OpenPOWERFoundation/toy-sram/cell.png

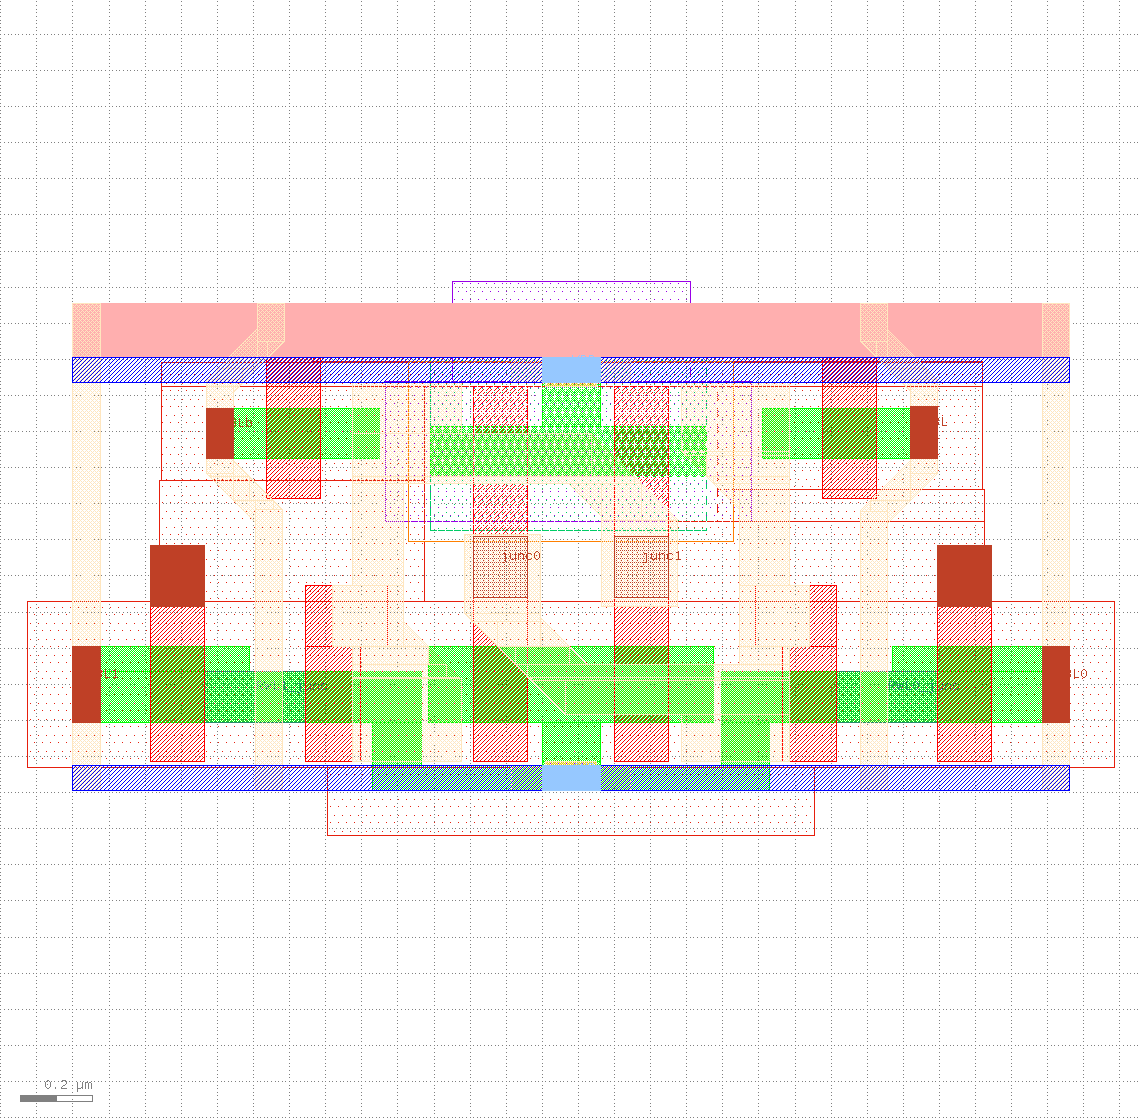
cell.png
