OpenPOWERFoundation/toy-sram/custom/10T.png

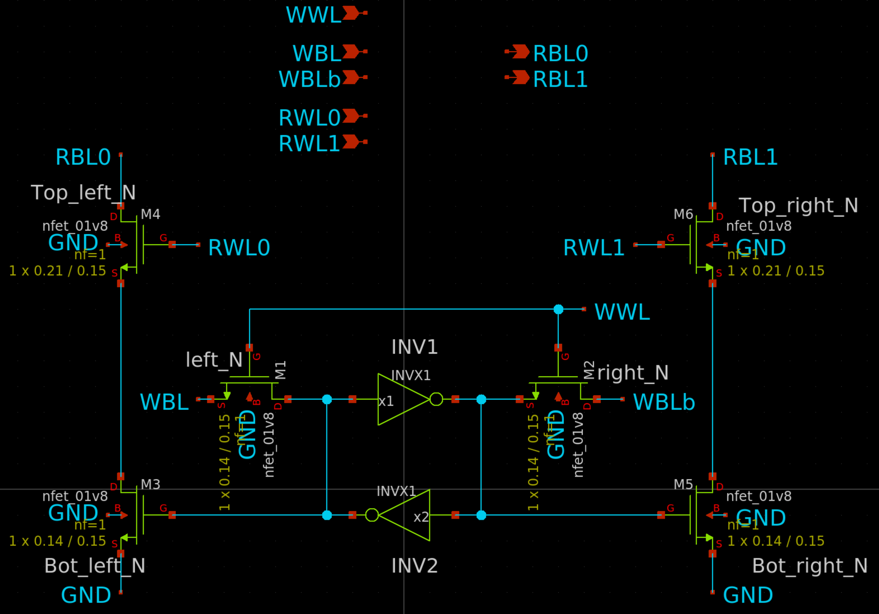
custom/10T.png
