OpenPOWERFoundation/toy-sram/custom/local_eval.png

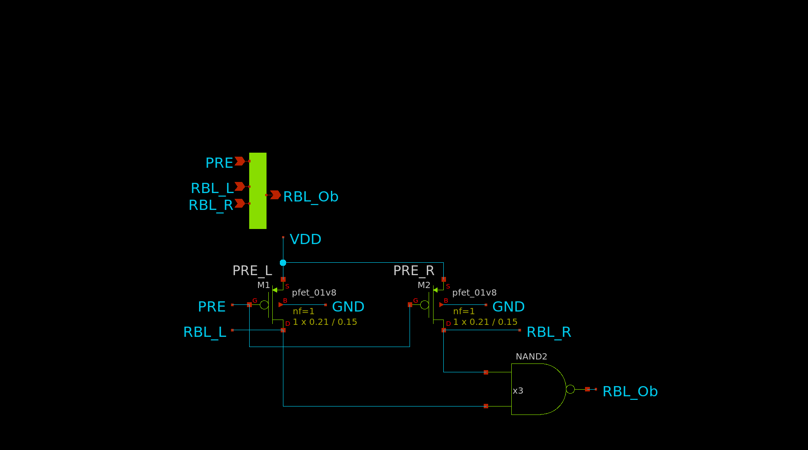
custom/local_eval.png
