OpenPOWERFoundation/toy-sram/custom/sim/Screenshot from 2022-05-25 16-05-57.png

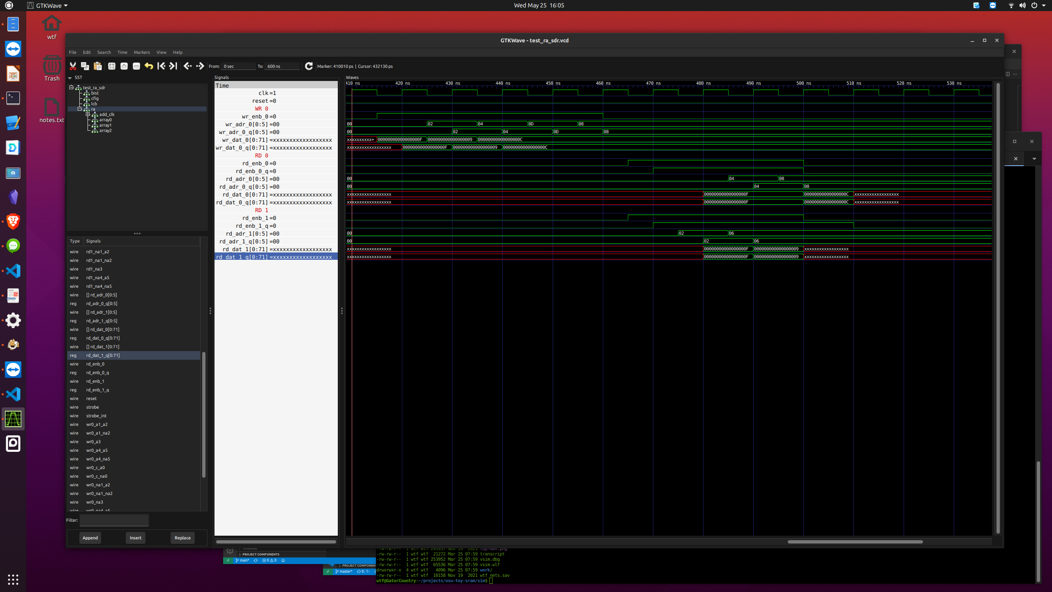
custom/sim/Screenshot from 2022-05-25 16-05-57.png
