OpenPOWERFoundation/toy-sram/custom/wtf/bit_v0.01.png

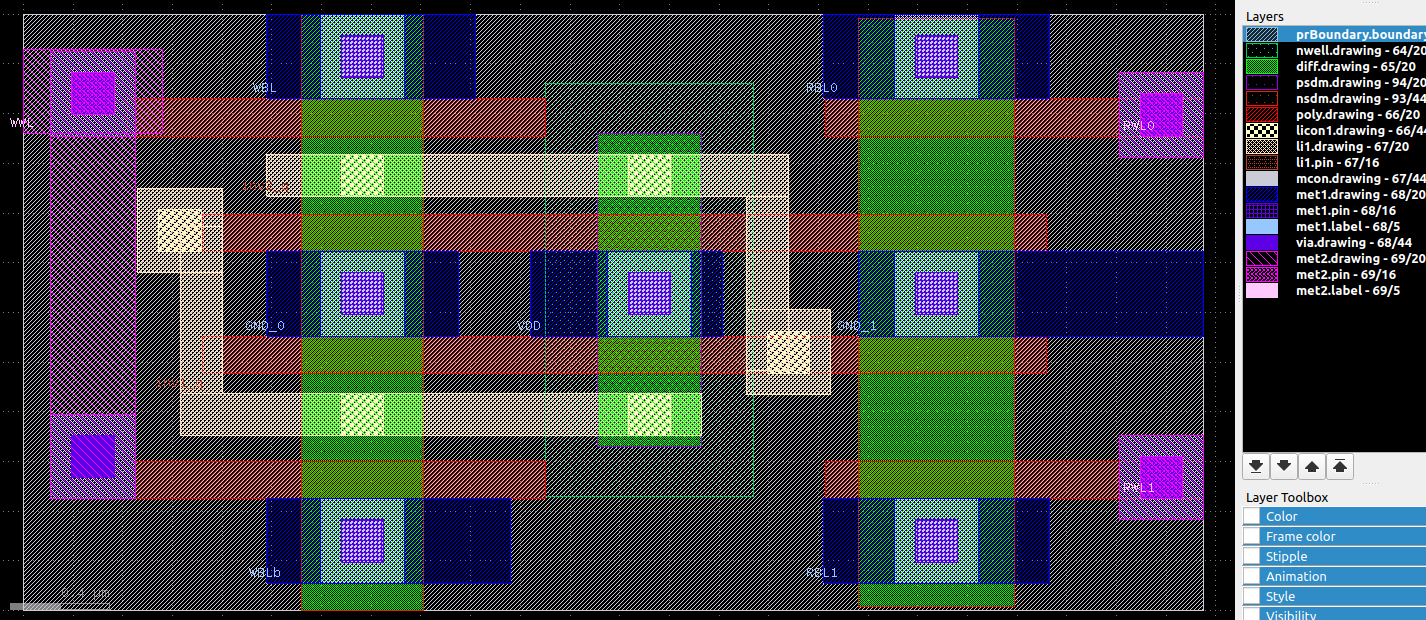
custom/wtf/bit_v0.01.png
