OpenPOWERFoundation/toy-sram/custom/wtf/irsim.png

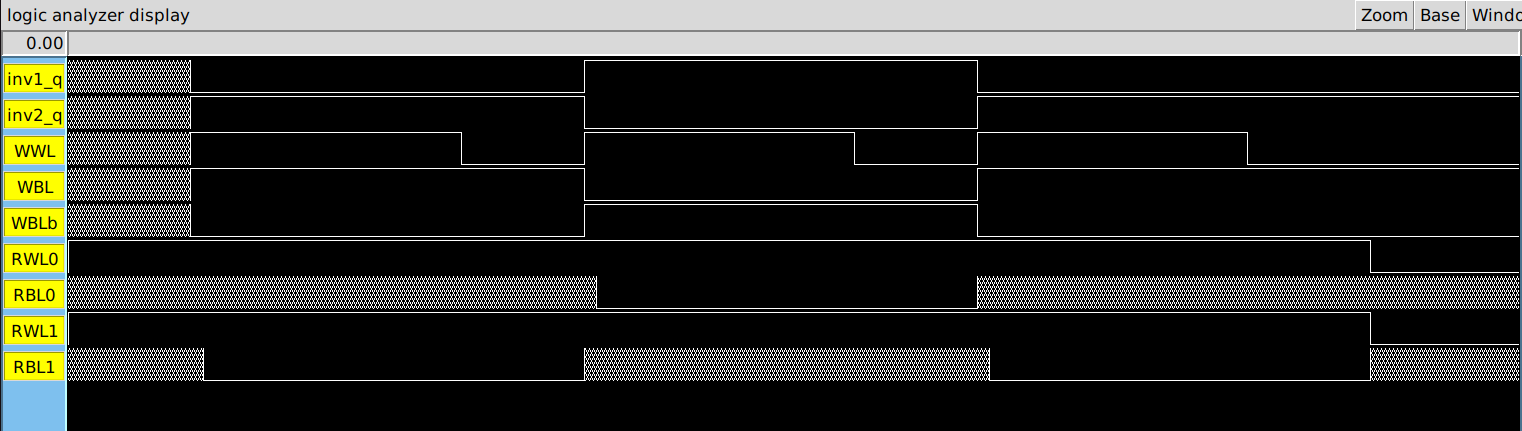
custom/wtf/irsim.png
