OpenPOWERFoundation/toy-sram/doc/slide1.png

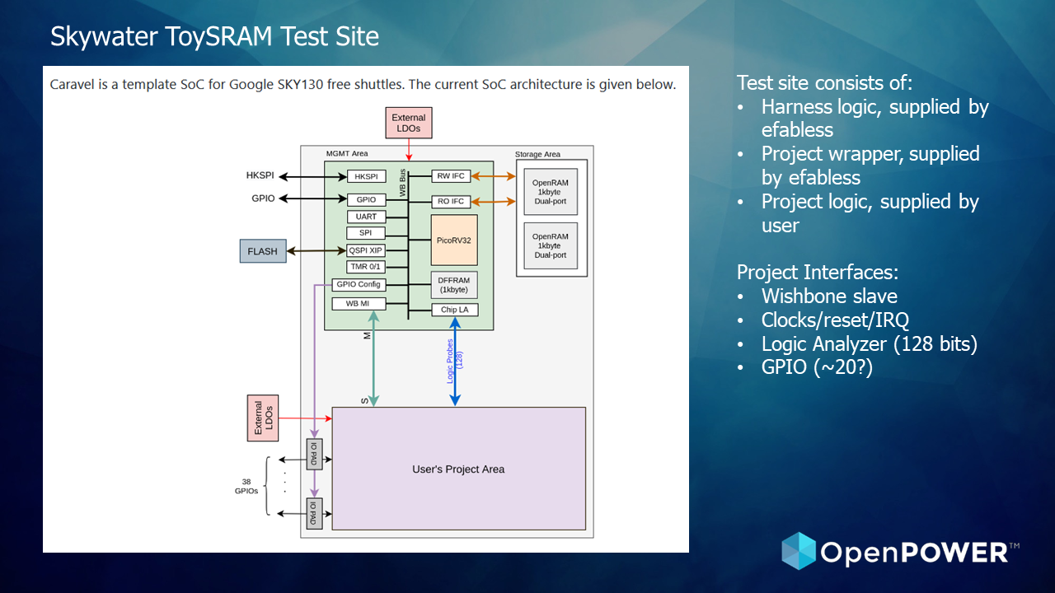
doc/slide1.png
