OpenPOWERFoundation/toy-sram/doc/slide3.png

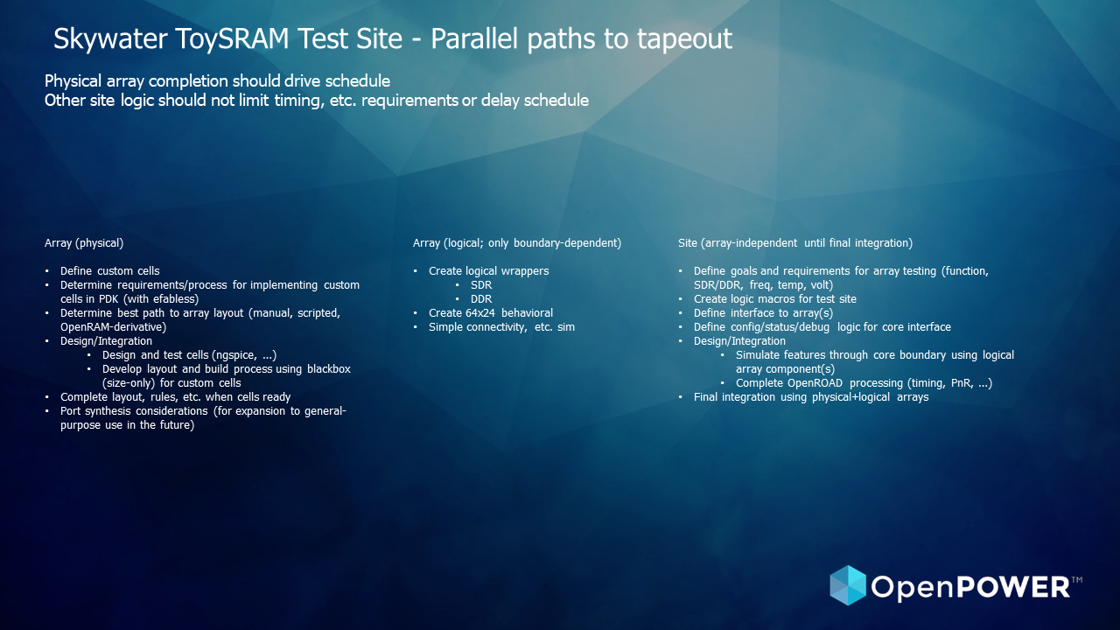
doc/slide3.png
