OpenPOWERFoundation/toy-sram/rtl/build/caravel/doc/img/bob.jpg

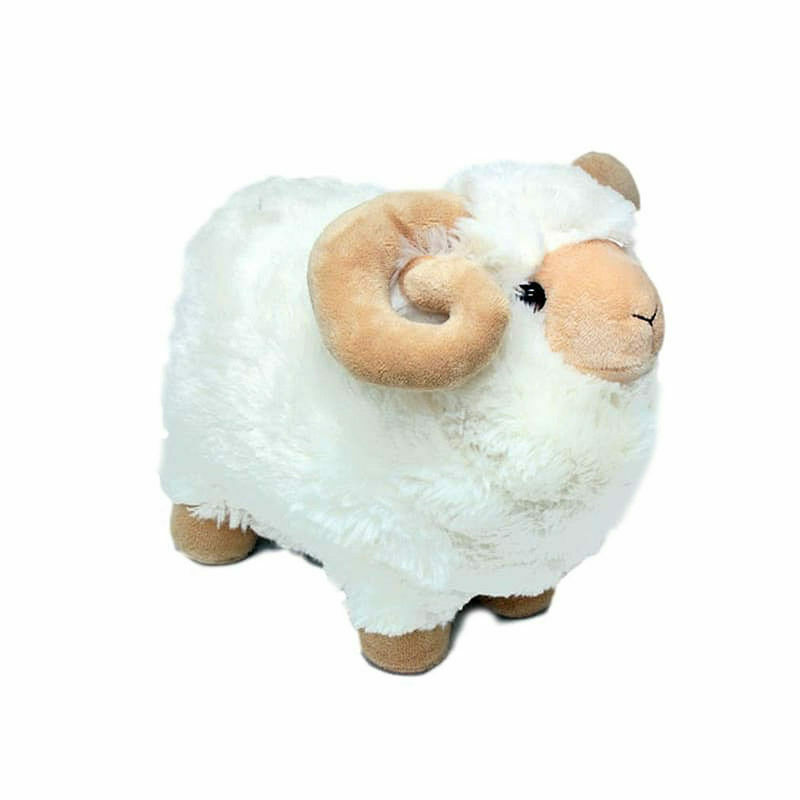
rtl/build/caravel/doc/img/bob.jpg
