OpenPOWERFoundation/toy-sram/custom/sky130A/libs.ref/sky130_fd_pr/spice/sky130_fd_pr__cap_vpp_55p8x23p1_pol1m1m2m3m4m5_noshield_test.spice

* Copyright 2020 The SkyWater PDK Authors
*
* Licensed under the Apache License, Version 2.0 (the "License");
* you may not use this file except in compliance with the License.
* You may obtain a copy of the License at
*
*     https://www.apache.org/licenses/LICENSE-2.0
*
* Unless required by applicable law or agreed to in writing, software
* distributed under the License is distributed on an "AS IS" BASIS,
* WITHOUT WARRANTIES OR CONDITIONS OF ANY KIND, either express or implied.
* See the License for the specific language governing permissions and
* limitations under the License.
*
* SPDX-License-Identifier: Apache-2.0


* Top level circuit sky130_fd_pr__cap_vpp_55p8x23p1_pol1m1m2m3m4m5_noshield_test
.end
