OpenPOWERFoundation/toy-sram/custom/lvs/10T_32x32_magic.spice

* HSPICE file created from 10T_32x32_magic.ext - technology: sky130A

.subckt x10T_toy_magic WWL RWL0 RWL1 WBL WBLb RBL0 RBL1 VDD GND
M1000 VDD junc0 junc1 VDD sky130_fd_pr__pfet_01v8 w=1 l=0.15
M1001 WBL WWL junc0 GND sky130_fd_pr__nfet_01v8 w=1 l=0.15
M1002 junc1 WWL WBLb GND sky130_fd_pr__nfet_01v8 w=1 l=0.15
M1003 GND junc0 junc1 GND sky130_fd_pr__nfet_01v8 w=1 l=0.15
M1004 RWL0_junc junc0 GND GND sky130_fd_pr__nfet_01v8 w=1 l=0.15
M1005 RBL0 RWL0 RWL0_junc GND sky130_fd_pr__nfet_01v8 w=1 l=0.15
M1006 GND junc1 RWL1_junc GND sky130_fd_pr__nfet_01v8 w=1 l=0.15
M1007 RWL1_junc RWL1 RBL1 GND sky130_fd_pr__nfet_01v8 w=1 l=0.15
M1008 junc0 junc1 GND GND sky130_fd_pr__nfet_01v8 w=1 l=0.15
M1009 junc0 junc1 VDD VDD sky130_fd_pr__pfet_01v8 w=1 l=0.15
.ends

.subckt x10T_1x8_magic RBL1_0 RBL0_0 RBL1_1 RBL0_1 RBL1_2 RBL0_2 RBL1_3 RBL1_4 RBL0_4
+ RBL1_5 RBL0_5 RBL1_6 RBL0_6 RBL1_7 RBL0_7 WWL RWL WBLb_0 WBL_0 WBLb_1 WBL_1 WBLb_2
+ WBL_2 WBLb_3 WBL_3 WBLb_4 WBL_4 WBLb_5 WBL_5 WBLb_6 WBL_6 WBLb_7 WBL_7 VDD GND x0/RBL0
+ x5/WBLb x5/RBL1 x4/WBLb x7/WBL x5/RBL0 x4/RBL1 x1/WBLb x4/RBL0 x6/WBL x1/RBL1 x1/RBL0
+ x7/WBLb x3/WBL x5/WWL x7/RBL1 x6/WBLb x7/RBL0 x2/WBL x6/RBL1 x6/RBL0 x0/WBL x5/VDD
+ x3/WBLb x5/WBL x3/RBL1 x2/WBLb x4/WBL x3/RBL0 x2/RBL1 x0/WBLb x2/RBL0 x1/WBL x0/RBL1
+ VSUBS
X10T_toy_magic_0 x5/WWL RWL RWL x0/WBL x0/WBLb x0/RBL0 x0/RBL1 x5/VDD VSUBS x10T_toy_magic
X10T_toy_magic_1 x5/WWL RWL RWL x1/WBL x1/WBLb x1/RBL0 x1/RBL1 x5/VDD VSUBS x10T_toy_magic
X10T_toy_magic_3 x5/WWL RWL RWL x2/WBL x2/WBLb x2/RBL0 x2/RBL1 x5/VDD VSUBS x10T_toy_magic
X10T_toy_magic_2 x5/WWL RWL RWL x6/WBL x6/WBLb x6/RBL0 x6/RBL1 x5/VDD VSUBS x10T_toy_magic
X10T_toy_magic_4 x5/WWL RWL RWL x4/WBL x4/WBLb x4/RBL0 x4/RBL1 x5/VDD VSUBS x10T_toy_magic
X10T_toy_magic_5 x5/WWL RWL RWL x7/WBL x7/WBLb x7/RBL0 x7/RBL1 x5/VDD VSUBS x10T_toy_magic
X10T_toy_magic_6 x5/WWL RWL RWL x3/WBL x3/WBLb x3/RBL0 x3/RBL1 x5/VDD VSUBS x10T_toy_magic
X10T_toy_magic_7 x5/WWL RWL RWL x5/WBL x5/WBLb x5/RBL0 x5/RBL1 x5/VDD VSUBS x10T_toy_magic
.ends

.subckt x10T_32x32_magic RBL1_0 RBL0_0 RBL1_1 RBL0_1 RBL1_2 RBL0_2 RBL1_3 RBL0_3 RBL1_4
+ RBL0_4 RBL1_5 RBL0_5 RBL1_6 RBL0_6 RBL1_7 RBL0_7 RBL1_8 RBL0_8 RBL1_9 RBL0_9 RBL1_10
+ RBL0_10 RBL1_11 RBL0_11 RBL1_12 RBL0_12 RBL1_13 RBL0_13 RBL1_14 RBL0_14 RBL1_15
+ RBL0_15 WWL_0 RWL_0 WWL_1 RWL_1 WWL_2 RWL_2 WWL_3 RWL_3 WWL_4 RWL_4 WWL_5 RWL_5
+ WWL_6 RWL_6 WWL_7 RWL_7 WWL_8 RWL_8 WWL_9 RWL_9 WWL_10 RWL_10 WWL_11 RWL_11 WWL_12
+ RWL_12 WWL_13 RWL_13 WWL_14 RWL_14 WWL_15 RWL_15 WWL_16 RWL_16 WWL_17 RWL_17 WWL_18
+ RWL_18 WWL_19 RWL_19 WWL_20 RWL_20 WWL_21 RWL_21 WWL_22 RWL_22 WWL_23 RWL_23 WWL_24
+ RWL_24 WWL_25 RWL_25 WWL_26 RWL_26 WWL_27 RWL_27 WWL_28 RWL_28 WWL_29 RWL_29 WWL_30
+ RWL_30 WWL_31 RWL_31 RBL1_16 RBL0_16 RBL1_17 RBL0_17 RBL1_18 RBL0_18 RBL1_19 RBL0_19
+ RBL1_20 RBL0_20 RBL1_21 RBL0_21 RBL1_22 RBL0_22 RBL1_23 RBL0_23 RBL1_24 RBL0_24
+ RBL1_25 RBL0_25 RBL1_26 RBL0_26 RBL1_27 RBL0_27 RBL1_28 RBL0_28 RBL1_29 RBL0_29
+ RBL1_30 RBL0_30 RBL1_31 RBL0_31 WBL_0 WBLb_0 WBL_1 WBLb_1 WBL_2 WBLb_2 WBL_3 WBLb_19
+ WBL_4 WBLb_4 WBL_5 WBLb_5 WBL_22 WBLb_6 WBL_23 WBLb_7 WBL_24 WBLb_8 WBL_25 WBLb_9
+ WBL_26 WBLb_10 WBL_11 WBLb_11 WBL_12 WBLb_12 WBL_13 WBLb_13 WBL_14 WBLb_30 WBL_15
+ WBLb_31 VDD GND
X10T_1x8_magic_0 RBL1_0 RBL0_0 RBL1_1 RBL0_1 RBL1_2 RBL0_2 RBL1_3 RBL1_4 RBL0_4 RBL1_5
+ RBL0_5 RBL1_6 RBL0_6 RBL1_7 RBL0_7 WWL_2 RWL_2 WBLb_0 WBL_0 WBLb_1 WBL_1 WBLb_2
+ WBL_2 WBLb_3 WBL_3 WBLb_4 WBL_4 WBLb_5 WBL_5 WBLb_6 WBL_6 WBLb_7 WBL_7 VDD GND RBL0_6
+ x0/WBLb RBL1_0 x1/WBLb x2/WBL RBL0_0 RBL1_3 x3/WBLb RBL0_3 x4/WBL RBL1_7 RBL0_7
+ x2/WBLb x5/WBL x6/WWL RBL1_2 x4/WBLb RBL0_2 x7/WBL RBL1_5 RBL0_5 x8/WBL x6/VDD x5/WBLb
+ x0/WBL RBL1_1 x7/WBLb x1/WBL RBL0_1 RBL1_4 x8/WBLb RBL0_4 x3/WBL RBL1_6 VSUBS x10T_1x8_magic
X10T_1x8_magic_1 RBL1_0 RBL0_0 RBL1_1 RBL0_1 RBL1_2 RBL0_2 RBL1_3 RBL1_4 RBL0_4 RBL1_5
+ RBL0_5 RBL1_6 RBL0_6 RBL1_7 RBL0_7 WWL_3 RWL_3 WBLb_0 WBL_0 WBLb_1 WBL_1 WBLb_2
+ WBL_2 WBLb_3 WBL_3 WBLb_4 WBL_4 WBLb_5 WBL_5 WBLb_6 WBL_6 WBLb_7 WBL_7 VDD GND x9/RBL0
+ x10/WBLb x10/RBL1 x11/WBLb x12/WBL x10/RBL0 x11/RBL1 x13/WBLb x11/RBL0 x14/WBL x13/RBL1
+ x13/RBL0 x12/WBLb x15/WBL x16/WWL x12/RBL1 x14/WBLb x12/RBL0 x17/WBL x14/RBL1 x14/RBL0
+ x9/WBL x16/VDD x15/WBLb x10/WBL x15/RBL1 x17/WBLb x11/WBL x15/RBL0 x17/RBL1 x9/WBLb
+ x17/RBL0 x13/WBL x9/RBL1 VSUBS x10T_1x8_magic
X10T_1x8_magic_2 RBL1_0 RBL0_0 RBL1_1 RBL0_1 RBL1_2 RBL0_2 RBL1_3 RBL1_4 RBL0_4 RBL1_5
+ RBL0_5 RBL1_6 RBL0_6 RBL1_7 RBL0_7 WWL_0 RWL_0 WBLb_0 WBL_0 WBLb_1 WBL_1 WBLb_2
+ WBL_2 WBLb_3 WBL_3 WBLb_4 WBL_4 WBLb_5 WBL_5 WBLb_6 WBL_6 WBLb_7 WBL_7 VDD GND x18/RBL0
+ x19/WBLb x19/RBL1 x20/WBLb x21/WBL x19/RBL0 x20/RBL1 x22/WBLb x20/RBL0 x23/WBL x22/RBL1
+ x22/RBL0 x21/WBLb x24/WBL x25/WWL x21/RBL1 x23/WBLb x21/RBL0 x26/WBL x23/RBL1 x23/RBL0
+ x18/WBL x25/VDD x24/WBLb x19/WBL x24/RBL1 x26/WBLb x20/WBL x24/RBL0 x26/RBL1 x18/WBLb
+ x26/RBL0 x22/WBL x18/RBL1 VSUBS x10T_1x8_magic
X10T_1x8_magic_3 RBL1_0 RBL0_0 RBL1_1 RBL0_1 RBL1_2 RBL0_2 RBL1_3 RBL1_4 RBL0_4 RBL1_5
+ RBL0_5 RBL1_6 RBL0_6 RBL1_7 RBL0_7 WWL_1 RWL_1 WBLb_0 WBL_0 WBLb_1 WBL_1 WBLb_2
+ WBL_2 WBLb_3 WBL_3 WBLb_4 WBL_4 WBLb_5 WBL_5 WBLb_6 WBL_6 WBLb_7 WBL_7 VDD GND x27/RBL0
+ x28/WBLb x28/RBL1 x29/WBLb x30/WBL x28/RBL0 x29/RBL1 x31/WBLb x29/RBL0 x32/WBL x31/RBL1
+ x31/RBL0 x30/WBLb x33/WBL x34/WWL x30/RBL1 x32/WBLb x30/RBL0 x35/WBL x32/RBL1 x32/RBL0
+ x27/WBL x34/VDD x33/WBLb x28/WBL x33/RBL1 x35/WBLb x29/WBL x33/RBL0 x35/RBL1 x27/WBLb
+ x35/RBL0 x31/WBL x27/RBL1 VSUBS x10T_1x8_magic
X10T_1x8_magic_4 RBL1_0 RBL0_0 RBL1_1 RBL0_1 RBL1_2 RBL0_2 RBL1_3 RBL1_4 RBL0_4 RBL1_5
+ RBL0_5 RBL1_6 RBL0_6 RBL1_7 RBL0_7 WWL_7 RWL_7 WBLb_0 WBL_0 WBLb_1 WBL_1 WBLb_2
+ WBL_2 WBLb_3 WBL_3 WBLb_4 WBL_4 WBLb_5 WBL_5 WBLb_6 WBL_6 WBLb_7 WBL_7 VDD GND RBL0_6
+ x36/WBLb RBL1_0 x37/WBLb x38/WBL RBL0_0 RBL1_3 x39/WBLb RBL0_3 x40/WBL RBL1_7 RBL0_7
+ x38/WBLb x41/WBL x42/WWL RBL1_2 x40/WBLb RBL0_2 x43/WBL RBL1_5 RBL0_5 x44/WBL x42/VDD
+ x41/WBLb x36/WBL RBL1_1 x43/WBLb x37/WBL RBL0_1 RBL1_4 x44/WBLb RBL0_4 x39/WBL RBL1_6
+ VSUBS x10T_1x8_magic
X10T_1x8_magic_5 RBL1_0 RBL0_0 RBL1_1 RBL0_1 RBL1_2 RBL0_2 RBL1_3 RBL1_4 RBL0_4 RBL1_5
+ RBL0_5 RBL1_6 RBL0_6 RBL1_7 RBL0_7 WWL_6 RWL_6 WBLb_0 WBL_0 WBLb_1 WBL_1 WBLb_2
+ WBL_2 WBLb_3 WBL_3 WBLb_4 WBL_4 WBLb_5 WBL_5 WBLb_6 WBL_6 WBLb_7 WBL_7 VDD GND x45/RBL0
+ x46/WBLb x46/RBL1 x47/WBLb x48/WBL x46/RBL0 x47/RBL1 x49/WBLb x47/RBL0 x50/WBL x49/RBL1
+ x49/RBL0 x48/WBLb x51/WBL x52/WWL x48/RBL1 x50/WBLb x48/RBL0 x53/WBL x50/RBL1 x50/RBL0
+ x45/WBL x52/VDD x51/WBLb x46/WBL x51/RBL1 x53/WBLb x47/WBL x51/RBL0 x53/RBL1 x45/WBLb
+ x53/RBL0 x49/WBL x45/RBL1 VSUBS x10T_1x8_magic
X10T_1x8_magic_6 RBL1_0 RBL0_0 RBL1_1 RBL0_1 RBL1_2 RBL0_2 RBL1_3 RBL1_4 RBL0_4 RBL1_5
+ RBL0_5 RBL1_6 RBL0_6 RBL1_7 RBL0_7 WWL_4 RWL_4 WBLb_0 WBL_0 WBLb_1 WBL_1 WBLb_2
+ WBL_2 WBLb_3 WBL_3 WBLb_4 WBL_4 WBLb_5 WBL_5 WBLb_6 WBL_6 WBLb_7 WBL_7 VDD GND x54/RBL0
+ WBLb_0 x55/RBL1 WBLb_3 WBL_2 x55/RBL0 x56/RBL1 WBLb_7 x56/RBL0 WBL_5 x57/RBL1 x57/RBL0
+ WBLb_2 WBL_1 x58/WWL x59/RBL1 WBLb_5 x59/RBL0 WBL_4 x60/RBL1 x60/RBL0 WBL_6 x58/VDD
+ WBLb_1 WBL_0 x61/RBL1 WBLb_4 WBL_3 x61/RBL0 x62/RBL1 WBLb_6 x62/RBL0 WBL_7 x54/RBL1
+ VSUBS x10T_1x8_magic
X10T_1x8_magic_7 RBL1_0 RBL0_0 RBL1_1 RBL0_1 RBL1_2 RBL0_2 RBL1_3 RBL1_4 RBL0_4 RBL1_5
+ RBL0_5 RBL1_6 RBL0_6 RBL1_7 RBL0_7 WWL_5 RWL_5 WBLb_0 WBL_0 WBLb_1 WBL_1 WBLb_2
+ WBL_2 WBLb_3 WBL_3 WBLb_4 WBL_4 WBLb_5 WBL_5 WBLb_6 WBL_6 WBLb_7 WBL_7 VDD GND x63/RBL0
+ x64/WBLb x64/RBL1 x65/WBLb x66/WBL x64/RBL0 x65/RBL1 x67/WBLb x65/RBL0 x68/WBL x67/RBL1
+ x67/RBL0 x66/WBLb x69/WBL x70/WWL x66/RBL1 x68/WBLb x66/RBL0 x71/WBL x68/RBL1 x68/RBL0
+ x63/WBL x70/VDD x69/WBLb x64/WBL x69/RBL1 x71/WBLb x65/WBL x69/RBL0 x71/RBL1 x63/WBLb
+ x71/RBL0 x67/WBL x63/RBL1 VSUBS x10T_1x8_magic
X10T_1x8_magic_90 RBL1_16 RBL0_16 RBL1_17 RBL0_17 RBL1_18 RBL0_18 RBL1_19 RBL1_20
+ RBL0_20 RBL1_21 RBL0_21 RBL1_22 RBL0_22 RBL1_23 RBL0_23 x72/WWL RWL_17 WBLb_16 WBL_16
+ WBLb_17 WBL_17 WBLb_18 WBL_18 WBLb_19 WBL_19 WBLb_20 WBL_20 WBLb_21 WBL_21 WBLb_22
+ WBL_22 WBLb_23 WBL_23 x72/VDD VSUBS x73/RBL0 WBLb_16 x74/RBL1 x75/WBLb x76/WBL x74/RBL0
+ x75/RBL1 x77/WBLb x75/RBL0 x78/WBL x77/RBL1 x77/RBL0 x76/WBLb x79/WBL x80/WWL x76/RBL1
+ x78/WBLb x76/RBL0 x81/WBL RBL1_21 x78/RBL0 x73/WBL x80/VDD x79/WBLb x74/WBL x79/RBL1
+ x81/WBLb x75/WBL x79/RBL0 x81/RBL1 x73/WBLb x81/RBL0 x77/WBL x73/RBL1 VSUBS x10T_1x8_magic
X10T_1x8_magic_8 RBL1_0 RBL0_0 RBL1_1 RBL0_1 RBL1_2 RBL0_2 RBL1_3 RBL1_4 RBL0_4 RBL1_5
+ RBL0_5 RBL1_6 RBL0_6 RBL1_7 RBL0_7 WWL_14 RWL_14 WBLb_0 WBL_0 WBLb_1 WBL_1 WBLb_2
+ WBL_2 WBLb_3 WBL_3 WBLb_4 WBL_4 WBLb_5 WBL_5 WBLb_6 WBL_6 WBLb_7 WBL_7 VDD GND RBL0_6
+ WBLb_0 RBL1_0 WBLb_3 WBL_2 RBL0_0 RBL1_3 WBLb_7 RBL0_3 WBL_5 RBL1_7 RBL0_7 WBLb_2
+ WBL_1 x82/WWL RBL1_2 WBLb_5 RBL0_2 WBL_4 RBL1_5 RBL0_5 WBL_6 x82/VDD WBLb_1 WBL_0
+ RBL1_1 WBLb_4 WBL_3 RBL0_1 RBL1_4 WBLb_6 RBL0_4 WBL_7 RBL1_6 VSUBS x10T_1x8_magic
X10T_1x8_magic_80 RBL1_16 RBL0_16 RBL1_17 RBL0_17 RBL1_18 RBL0_18 RBL1_19 RBL1_20
+ RBL0_20 RBL1_21 RBL0_21 RBL1_22 RBL0_22 RBL1_23 RBL0_23 x83/WWL RWL_23 WBLb_16 WBL_16
+ WBLb_17 WBL_17 WBLb_18 WBL_18 WBLb_19 WBL_19 WBLb_20 WBL_20 WBLb_21 WBL_21 WBLb_22
+ WBL_22 WBLb_23 WBL_23 VDD VSUBS RBL0_22 WBLb_16 RBL1_16 WBLb_19 WBL_18 RBL0_16 RBL1_19
+ WBLb_23 RBL0_19 WBL_21 RBL1_23 RBL0_23 WBLb_18 WBL_17 x84/WWL RBL1_18 WBLb_21 RBL0_18
+ WBL_20 RBL1_21 RBL0_21 WBL_22 VDD WBLb_17 WBL_16 RBL1_17 WBLb_20 WBL_19 RBL0_17
+ RBL1_20 WBLb_22 RBL0_20 WBL_23 RBL1_22 VSUBS x10T_1x8_magic
X10T_1x8_magic_91 RBL1_16 RBL0_16 RBL1_17 RBL0_17 RBL1_18 RBL0_18 RBL1_19 RBL1_20
+ RBL0_20 RBL1_21 RBL0_21 RBL1_22 RBL0_22 RBL1_23 RBL0_23 x85/WWL RWL_18 WBLb_16 WBL_16
+ WBLb_17 WBL_17 WBLb_18 WBL_18 WBLb_19 WBL_19 WBLb_20 WBL_20 WBLb_21 WBL_21 WBLb_22
+ WBL_22 WBLb_23 WBL_23 x85/VDD VSUBS x86/RBL0 WBLb_16 x87/RBL1 x88/WBLb x89/WBL x87/RBL0
+ x88/RBL1 x90/WBLb x88/RBL0 x91/WBL x90/RBL1 x90/RBL0 x89/WBLb x92/WBL x93/WWL x89/RBL1
+ x91/WBLb x89/RBL0 x94/WBL RBL1_21 x91/RBL0 x86/WBL x93/VDD x92/WBLb x87/WBL x92/RBL1
+ x94/WBLb x88/WBL x92/RBL0 x94/RBL1 x86/WBLb x94/RBL0 x90/WBL x86/RBL1 VSUBS x10T_1x8_magic
X10T_1x8_magic_70 RBL1_16 RBL0_16 RBL1_17 RBL0_17 RBL1_18 RBL0_18 RBL1_19 RBL1_20
+ RBL0_20 RBL1_21 RBL0_21 RBL1_22 RBL0_22 RBL1_23 RBL0_23 x95/WWL RWL_28 WBLb_16 WBL_16
+ WBLb_17 WBL_17 WBLb_18 WBL_18 WBLb_19 WBL_19 WBLb_20 WBL_20 WBLb_21 WBL_21 WBLb_22
+ WBL_22 WBLb_23 WBL_23 x95/VDD VSUBS RBL0_22 WBLb_16 RBL1_16 x96/WBLb x97/WBL RBL0_16
+ RBL1_19 x98/WBLb RBL0_19 x99/WBL RBL1_23 RBL0_23 x97/WBLb x100/WBL x101/WWL RBL1_18
+ x99/WBLb RBL0_18 x102/WBL RBL1_21 RBL0_21 x103/WBL x101/VDD x100/WBLb x104/WBL RBL1_17
+ x102/WBLb x96/WBL RBL0_17 RBL1_20 x103/WBLb RBL0_20 x98/WBL RBL1_22 VSUBS x10T_1x8_magic
X10T_1x8_magic_81 RBL1_24 RBL0_24 RBL1_25 RBL0_25 RBL1_26 RBL0_26 RBL1_27 RBL1_28
+ RBL0_28 RBL1_29 RBL0_29 RBL1_30 RBL0_30 RBL1_31 RBL0_31 x84/WWL RWL_23 WBLb_24 WBL_24
+ WBLb_25 WBL_25 WBLb_26 WBL_26 WBLb_27 WBL_27 WBLb_28 WBL_28 WBLb_29 WBL_29 WBLb_30
+ WBL_30 WBLb_31 WBL_31 VDD VSUBS RBL0_30 WBLb_24 RBL1_24 WBLb_27 WBL_26 RBL0_24 RBL1_27
+ WBLb_31 RBL0_27 WBL_29 RBL1_31 RBL0_31 WBLb_26 WBL_25 x105/WWL RBL1_26 WBLb_29 RBL0_26
+ WBL_28 RBL1_29 RBL0_29 WBL_30 VDD WBLb_25 WBL_24 RBL1_25 WBLb_28 WBL_27 RBL0_25
+ RBL1_28 WBLb_30 RBL0_28 WBL_31 RBL1_30 VSUBS x10T_1x8_magic
X10T_1x8_magic_92 RBL1_24 RBL0_24 RBL1_25 RBL0_25 RBL1_26 RBL0_26 RBL1_27 RBL1_28
+ RBL0_28 RBL1_29 RBL0_29 RBL1_30 RBL0_30 RBL1_31 RBL0_31 x80/WWL RWL_17 WBLb_24 WBL_24
+ WBLb_25 WBL_25 WBLb_26 WBL_26 WBLb_27 WBL_27 WBLb_28 WBL_28 WBLb_29 WBL_29 WBLb_30
+ WBL_30 WBLb_31 WBL_31 x80/VDD VSUBS x106/RBL0 x107/WBLb x107/RBL1 x108/WBLb x109/WBL
+ x107/RBL0 x108/RBL1 x110/WBLb x108/RBL0 x111/WBL x110/RBL1 x110/RBL0 x109/WBLb x112/WBL
+ x107/WWL x109/RBL1 x111/WBLb x109/RBL0 x113/WBL x111/RBL1 x111/RBL0 x106/WBL x107/VDD
+ x112/WBLb x107/WBL x112/RBL1 x113/WBLb x108/WBL x112/RBL0 x113/RBL1 x106/WBLb x113/RBL0
+ x110/WBL x106/RBL1 VSUBS x10T_1x8_magic
X10T_1x8_magic_9 RBL1_0 RBL0_0 RBL1_1 RBL0_1 RBL1_2 RBL0_2 RBL1_3 RBL1_4 RBL0_4 RBL1_5
+ RBL0_5 RBL1_6 RBL0_6 RBL1_7 RBL0_7 WWL_15 RWL_15 WBLb_0 WBL_0 WBLb_1 WBL_1 WBLb_2
+ WBL_2 WBLb_3 WBL_3 WBLb_4 WBL_4 WBLb_5 WBL_5 WBLb_6 WBL_6 WBLb_7 WBL_7 VDD GND x114/RBL0
+ x115/WBLb x115/RBL1 x116/WBLb x117/WBL x115/RBL0 x116/RBL1 x118/WBLb x116/RBL0 x119/WBL
+ x118/RBL1 x118/RBL0 x117/WBLb x120/WBL x121/WWL x117/RBL1 x119/WBLb x117/RBL0 x122/WBL
+ x119/RBL1 x119/RBL0 x114/WBL x121/VDD x120/WBLb x115/WBL x120/RBL1 x122/WBLb x116/WBL
+ x120/RBL0 x122/RBL1 x114/WBLb x122/RBL0 x118/WBL x114/RBL1 VSUBS x10T_1x8_magic
X10T_1x8_magic_60 RBL1_8 RBL0_8 RBL1_9 RBL0_9 RBL1_10 RBL0_10 RBL1_11 RBL1_12 RBL0_12
+ RBL1_13 RBL0_13 RBL1_14 RBL0_14 RBL1_15 RBL0_15 x16/WWL x16/RWL WBLb_8 WBL_8 WBLb_9
+ WBL_9 WBLb_10 WBL_10 WBLb_11 WBL_11 WBLb_12 WBL_12 WBLb_13 WBL_13 WBLb_14 WBL_14
+ WBLb_15 WBL_15 x16/VDD VSUBS x123/RBL0 x124/WBLb x124/RBL1 x125/WBLb x126/WBL x124/RBL0
+ x125/RBL1 x127/WBLb x125/RBL0 x128/WBL x127/RBL1 x127/RBL0 x126/WBLb x129/WBL x130/WWL
+ x126/RBL1 x128/WBLb x126/RBL0 x131/WBL x128/RBL1 x128/RBL0 x123/WBL x130/VDD x129/WBLb
+ x124/WBL x129/RBL1 x131/WBLb x125/WBL x129/RBL0 x131/RBL1 x123/WBLb x131/RBL0 x127/WBL
+ x123/RBL1 VSUBS x10T_1x8_magic
X10T_1x8_magic_71 RBL1_24 RBL0_24 RBL1_25 RBL0_25 RBL1_26 RBL0_26 RBL1_27 RBL1_28
+ RBL0_28 RBL1_29 RBL0_29 RBL1_30 RBL0_30 RBL1_31 RBL0_31 x101/WWL RWL_28 WBLb_24
+ WBL_24 WBLb_25 WBL_25 WBLb_26 WBL_26 WBLb_27 WBL_27 WBLb_28 WBL_28 WBLb_29 WBL_29
+ WBLb_30 WBL_30 WBLb_31 WBL_31 x101/VDD VSUBS RBL0_30 x132/WBLb RBL1_24 x133/WBLb
+ x134/WBL RBL0_24 RBL1_27 x135/WBLb RBL0_27 x136/WBL RBL1_31 RBL0_31 x134/WBLb x137/WBL
+ x132/WWL RBL1_26 x136/WBLb RBL0_26 x138/WBL RBL1_29 RBL0_29 x139/WBL x132/VDD x137/WBLb
+ x132/WBL RBL1_25 x138/WBLb x133/WBL RBL0_25 RBL1_28 x139/WBLb RBL0_28 x135/WBL RBL1_30
+ VSUBS x10T_1x8_magic
X10T_1x8_magic_82 RBL1_16 RBL0_16 RBL1_17 RBL0_17 RBL1_18 RBL0_18 RBL1_19 RBL1_20
+ RBL0_20 RBL1_21 RBL0_21 RBL1_22 RBL0_22 RBL1_23 RBL0_23 x140/WWL RWL_22 WBLb_16
+ WBL_16 WBLb_17 WBL_17 WBLb_18 WBL_18 WBLb_19 WBL_19 WBLb_20 WBL_20 WBLb_21 WBL_21
+ WBLb_22 WBL_22 WBLb_23 WBL_23 x140/VDD VSUBS x141/RBL0 WBLb_16 x142/RBL1 x143/WBLb
+ x144/WBL x142/RBL0 x143/RBL1 x145/WBLb x143/RBL0 x146/WBL x145/RBL1 x145/RBL0 x144/WBLb
+ x147/WBL x148/WWL x144/RBL1 x146/WBLb x144/RBL0 x149/WBL RBL1_21 x146/RBL0 x141/WBL
+ x148/VDD x147/WBLb x142/WBL x147/RBL1 x149/WBLb x143/WBL x147/RBL0 x149/RBL1 x141/WBLb
+ x149/RBL0 x145/WBL x141/RBL1 VSUBS x10T_1x8_magic
X10T_1x8_magic_93 RBL1_24 RBL0_24 RBL1_25 RBL0_25 RBL1_26 RBL0_26 RBL1_27 RBL1_28
+ RBL0_28 RBL1_29 RBL0_29 RBL1_30 RBL0_30 RBL1_31 RBL0_31 x93/WWL RWL_18 WBLb_24 WBL_24
+ WBLb_25 WBL_25 WBLb_26 WBL_26 WBLb_27 WBL_27 WBLb_28 WBL_28 WBLb_29 WBL_29 WBLb_30
+ WBL_30 WBLb_31 WBL_31 x93/VDD VSUBS x150/RBL0 x151/WBLb x151/RBL1 x152/WBLb x153/WBL
+ x151/RBL0 x152/RBL1 x154/WBLb x152/RBL0 x155/WBL x154/RBL1 x154/RBL0 x153/WBLb x156/WBL
+ x151/WWL x153/RBL1 x155/WBLb x153/RBL0 x157/WBL x155/RBL1 x155/RBL0 x150/WBL x151/VDD
+ x156/WBLb x151/WBL x156/RBL1 x157/WBLb x152/WBL x156/RBL0 x157/RBL1 x150/WBLb x157/RBL0
+ x154/WBL x150/RBL1 VSUBS x10T_1x8_magic
X10T_1x8_magic_61 RBL1_8 RBL0_8 RBL1_9 RBL0_9 RBL1_10 RBL0_10 RBL1_11 RBL1_12 RBL0_12
+ RBL1_13 RBL0_13 RBL1_14 RBL0_14 RBL1_15 RBL0_15 x6/WWL RWL_2 WBLb_8 WBL_8 WBLb_9
+ WBL_9 WBLb_10 WBL_10 WBLb_11 WBL_11 WBLb_12 WBL_12 WBLb_13 WBL_13 WBLb_14 WBL_14
+ WBLb_15 WBL_15 x6/VDD VSUBS RBL0_14 x158/WBLb RBL1_8 x159/WBLb x160/WBL RBL0_8 RBL1_11
+ x161/WBLb RBL0_11 x162/WBL RBL1_15 RBL0_15 x160/WBLb x163/WBL x164/WWL RBL1_10 x162/WBLb
+ RBL0_10 x165/WBL RBL1_13 RBL0_13 x166/WBL x164/VDD x163/WBLb x158/WBL RBL1_9 x165/WBLb
+ x159/WBL RBL0_9 RBL1_12 x166/WBLb RBL0_12 x161/WBL RBL1_14 VSUBS x10T_1x8_magic
X10T_1x8_magic_72 RBL1_16 RBL0_16 RBL1_17 RBL0_17 RBL1_18 RBL0_18 RBL1_19 RBL1_20
+ RBL0_20 RBL1_21 RBL0_21 RBL1_22 RBL0_22 RBL1_23 RBL0_23 x167/WWL RWL_27 WBLb_16
+ WBL_16 WBLb_17 WBL_17 WBLb_18 WBL_18 WBLb_19 WBL_19 WBLb_20 WBL_20 WBLb_21 WBL_21
+ WBLb_22 WBL_22 WBLb_23 WBL_23 x167/VDD VSUBS x168/RBL0 WBLb_16 x169/RBL1 x170/WBLb
+ x171/WBL x169/RBL0 x170/RBL1 x172/WBLb x170/RBL0 x173/WBL x172/RBL1 x172/RBL0 x171/WBLb
+ x174/WBL x175/WWL x171/RBL1 x173/WBLb x171/RBL0 x176/WBL RBL1_21 x173/RBL0 x168/WBL
+ x175/VDD x174/WBLb x169/WBL x174/RBL1 x176/WBLb x170/WBL x174/RBL0 x176/RBL1 x168/WBLb
+ x176/RBL0 x172/WBL x168/RBL1 VSUBS x10T_1x8_magic
X10T_1x8_magic_83 RBL1_24 RBL0_24 RBL1_25 RBL0_25 RBL1_26 RBL0_26 RBL1_27 RBL1_28
+ RBL0_28 RBL1_29 RBL0_29 RBL1_30 RBL0_30 RBL1_31 RBL0_31 x148/WWL RWL_22 WBLb_24
+ WBL_24 WBLb_25 WBL_25 WBLb_26 WBL_26 WBLb_27 WBL_27 WBLb_28 WBL_28 WBLb_29 WBL_29
+ WBLb_30 WBL_30 WBLb_31 WBL_31 x148/VDD VSUBS x177/RBL0 x178/WBLb x178/RBL1 x179/WBLb
+ x180/WBL x178/RBL0 x179/RBL1 x181/WBLb x179/RBL0 x182/WBL x181/RBL1 x181/RBL0 x180/WBLb
+ x183/WBL x178/WWL x180/RBL1 x182/WBLb x180/RBL0 x184/WBL x182/RBL1 x182/RBL0 x177/WBL
+ x178/VDD x183/WBLb x178/WBL x183/RBL1 x184/WBLb x179/WBL x183/RBL0 x184/RBL1 x177/WBLb
+ x184/RBL0 x181/WBL x177/RBL1 VSUBS x10T_1x8_magic
X10T_1x8_magic_94 RBL1_16 RBL0_16 RBL1_17 RBL0_17 RBL1_18 RBL0_18 RBL1_19 RBL1_20
+ RBL0_20 RBL1_21 RBL0_21 RBL1_22 RBL0_22 RBL1_23 RBL0_23 x185/WWL RWL_16 WBLb_16
+ WBL_16 WBLb_17 WBL_17 WBLb_18 WBL_18 WBLb_19 WBL_19 WBLb_20 WBL_20 WBLb_21 WBL_21
+ WBLb_22 WBL_22 WBLb_23 WBL_23 x185/VDD VSUBS x186/RBL0 WBLb_16 x187/RBL1 x188/WBLb
+ x189/WBL x187/RBL0 x188/RBL1 x190/WBLb x188/RBL0 x191/WBL x190/RBL1 x190/RBL0 x189/WBLb
+ x192/WBL x193/WWL x189/RBL1 x191/WBLb x189/RBL0 x194/WBL RBL1_21 x191/RBL0 x186/WBL
+ x193/VDD x192/WBLb x187/WBL x192/RBL1 x194/WBLb x188/WBL x192/RBL0 x194/RBL1 x186/WBLb
+ x194/RBL0 x190/WBL x186/RBL1 VSUBS x10T_1x8_magic
X10T_1x8_magic_50 RBL1_8 RBL0_8 RBL1_9 RBL0_9 RBL1_10 RBL0_10 RBL1_11 RBL1_12 RBL0_12
+ RBL1_13 RBL0_13 RBL1_14 RBL0_14 RBL1_15 RBL0_15 x195/WWL RWL_13 WBLb_8 WBL_8 WBLb_9
+ WBL_9 WBLb_10 WBL_10 WBLb_11 WBL_11 WBLb_12 WBL_12 WBLb_13 WBL_13 WBLb_14 WBL_14
+ WBLb_15 WBL_15 x195/VDD VSUBS x196/RBL0 x197/WBLb x197/RBL1 x198/WBLb x199/WBL x197/RBL0
+ x198/RBL1 x200/WBLb x198/RBL0 x201/WBL x200/RBL1 x200/RBL0 x199/WBLb x202/WBL x203/WWL
+ x199/RBL1 x201/WBLb x199/RBL0 x204/WBL x201/RBL1 x201/RBL0 x196/WBL x203/VDD x202/WBLb
+ x197/WBL x202/RBL1 x204/WBLb x198/WBL x202/RBL0 x204/RBL1 x196/WBLb x204/RBL0 x200/WBL
+ x196/RBL1 VSUBS x10T_1x8_magic
X10T_1x8_magic_62 RBL1_8 RBL0_8 RBL1_9 RBL0_9 RBL1_10 RBL0_10 RBL1_11 RBL1_12 RBL0_12
+ RBL1_13 RBL0_13 RBL1_14 RBL0_14 RBL1_15 RBL0_15 x34/WWL RWL_1 WBLb_8 WBL_8 WBLb_9
+ WBL_9 WBLb_10 WBL_10 WBLb_11 WBL_11 WBLb_12 WBL_12 WBLb_13 WBL_13 WBLb_14 WBL_14
+ WBLb_15 WBL_15 x34/VDD VSUBS x205/RBL0 x206/WBLb x206/RBL1 x207/WBLb x208/WBL x206/RBL0
+ x207/RBL1 x209/WBLb x207/RBL0 x210/WBL x209/RBL1 x209/RBL0 x208/WBLb x211/WBL x212/WWL
+ x208/RBL1 x210/WBLb x208/RBL0 x213/WBL x210/RBL1 x210/RBL0 x205/WBL x212/VDD x211/WBLb
+ x206/WBL x211/RBL1 x213/WBLb x207/WBL x211/RBL0 x213/RBL1 x205/WBLb x213/RBL0 x209/WBL
+ x205/RBL1 VSUBS x10T_1x8_magic
X10T_1x8_magic_120 RBL1_16 RBL0_16 RBL1_17 RBL0_17 RBL1_18 RBL0_18 RBL1_19 RBL1_20
+ RBL0_20 RBL1_21 RBL0_21 RBL1_22 RBL0_22 RBL1_23 RBL0_23 x130/WWL x16/RWL WBLb_16
+ WBL_16 WBLb_17 WBL_17 WBLb_18 WBL_18 WBLb_19 WBL_19 WBLb_20 WBL_20 WBLb_21 WBL_21
+ WBLb_22 WBL_22 WBLb_23 WBL_23 x130/VDD VSUBS x214/RBL0 WBLb_16 x215/RBL1 x216/WBLb
+ x217/WBL x215/RBL0 x216/RBL1 x218/WBLb x216/RBL0 x219/WBL x218/RBL1 x218/RBL0 x217/WBLb
+ x220/WBL x221/WWL x217/RBL1 x219/WBLb x217/RBL0 x222/WBL RBL1_21 x219/RBL0 x214/WBL
+ x221/VDD x220/WBLb x215/WBL x220/RBL1 x222/WBLb x216/WBL x220/RBL0 x222/RBL1 x214/WBLb
+ x222/RBL0 x218/WBL x214/RBL1 VSUBS x10T_1x8_magic
X10T_1x8_magic_73 RBL1_24 RBL0_24 RBL1_25 RBL0_25 RBL1_26 RBL0_26 RBL1_27 RBL1_28
+ RBL0_28 RBL1_29 RBL0_29 RBL1_30 RBL0_30 RBL1_31 RBL0_31 x175/WWL RWL_27 WBLb_24
+ WBL_24 WBLb_25 WBL_25 WBLb_26 WBL_26 WBLb_27 WBL_27 WBLb_28 WBL_28 WBLb_29 WBL_29
+ WBLb_30 WBL_30 WBLb_31 WBL_31 x175/VDD VSUBS x223/RBL0 x224/WBLb x224/RBL1 x225/WBLb
+ x226/WBL x224/RBL0 x225/RBL1 x227/WBLb x225/RBL0 x228/WBL x227/RBL1 x227/RBL0 x226/WBLb
+ x229/WBL x224/WWL x226/RBL1 x228/WBLb x226/RBL0 x230/WBL x228/RBL1 x228/RBL0 x223/WBL
+ x224/VDD x229/WBLb x224/WBL x229/RBL1 x230/WBLb x225/WBL x229/RBL0 x230/RBL1 x223/WBLb
+ x230/RBL0 x227/WBL x223/RBL1 VSUBS x10T_1x8_magic
X10T_1x8_magic_40 RBL1_8 RBL0_8 RBL1_9 RBL0_9 RBL1_10 RBL0_10 RBL1_11 RBL1_12 RBL0_12
+ RBL1_13 RBL0_13 RBL1_14 RBL0_14 RBL1_15 RBL0_15 x231/WWL RWL_25 WBLb_8 WBL_8 WBLb_9
+ WBL_9 WBLb_10 WBL_10 WBLb_11 WBL_11 WBLb_12 WBL_12 WBLb_13 WBL_13 WBLb_14 WBL_14
+ WBLb_15 WBL_15 x231/VDD VSUBS x232/RBL0 WBLb_8 x233/RBL1 WBLb_11 WBL_10 x233/RBL0
+ x234/RBL1 WBLb_15 x234/RBL0 WBL_13 x235/RBL1 x235/RBL0 WBLb_10 WBL_9 x236/WWL x237/RBL1
+ WBLb_13 x237/RBL0 WBL_12 x238/RBL1 x238/RBL0 WBL_14 x236/VDD WBLb_9 WBL_8 x239/RBL1
+ WBLb_12 WBL_11 x239/RBL0 x240/RBL1 WBLb_14 x240/RBL0 WBL_15 x232/RBL1 VSUBS x10T_1x8_magic
X10T_1x8_magic_84 RBL1_16 RBL0_16 RBL1_17 RBL0_17 RBL1_18 RBL0_18 RBL1_19 RBL1_20
+ RBL0_20 RBL1_21 RBL0_21 RBL1_22 RBL0_22 RBL1_23 RBL0_23 x241/WWL RWL_21 WBLb_16
+ WBL_16 WBLb_17 WBL_17 WBLb_18 WBL_18 WBLb_19 WBL_19 WBLb_20 WBL_20 WBLb_21 WBL_21
+ WBLb_22 WBL_22 WBLb_23 WBL_23 x241/VDD VSUBS x242/RBL0 WBLb_16 x243/RBL1 x244/WBLb
+ x245/WBL x243/RBL0 x244/RBL1 x246/WBLb x244/RBL0 x247/WBL x246/RBL1 x246/RBL0 x245/WBLb
+ x248/WBL x249/WWL x245/RBL1 x247/WBLb x245/RBL0 x250/WBL RBL1_21 x247/RBL0 x242/WBL
+ x249/VDD x248/WBLb x243/WBL x248/RBL1 x250/WBLb x244/WBL x248/RBL0 x250/RBL1 x242/WBLb
+ x250/RBL0 x246/WBL x242/RBL1 VSUBS x10T_1x8_magic
X10T_1x8_magic_95 RBL1_24 RBL0_24 RBL1_25 RBL0_25 RBL1_26 RBL0_26 RBL1_27 RBL1_28
+ RBL0_28 RBL1_29 RBL0_29 RBL1_30 RBL0_30 RBL1_31 RBL0_31 x193/WWL RWL_16 WBLb_24
+ WBL_24 WBLb_25 WBL_25 WBLb_26 WBL_26 WBLb_27 WBL_27 WBLb_28 WBL_28 WBLb_29 WBL_29
+ WBLb_30 WBL_30 WBLb_31 WBL_31 x193/VDD VSUBS x251/RBL0 x252/WBLb x252/RBL1 x253/WBLb
+ x254/WBL x252/RBL0 x253/RBL1 x255/WBLb x253/RBL0 x256/WBL x255/RBL1 x255/RBL0 x254/WBLb
+ x257/WBL x252/WWL x254/RBL1 x256/WBLb x254/RBL0 x258/WBL x256/RBL1 x256/RBL0 x251/WBL
+ x252/VDD x257/WBLb x252/WBL x257/RBL1 x258/WBLb x253/WBL x257/RBL0 x258/RBL1 x251/WBLb
+ x258/RBL0 x255/WBL x251/RBL1 VSUBS x10T_1x8_magic
X10T_1x8_magic_51 RBL1_8 RBL0_8 RBL1_9 RBL0_9 RBL1_10 RBL0_10 RBL1_11 RBL1_12 RBL0_12
+ RBL1_13 RBL0_13 RBL1_14 RBL0_14 RBL1_15 RBL0_15 x259/WWL RWL_12 WBLb_8 WBL_8 WBLb_9
+ WBL_9 WBLb_10 WBL_10 WBLb_11 WBL_11 WBLb_12 WBL_12 WBLb_13 WBL_13 WBLb_14 WBL_14
+ WBLb_15 WBL_15 x259/VDD VSUBS RBL0_14 x260/WBLb RBL1_8 x261/WBLb x262/WBL RBL0_8
+ RBL1_11 x263/WBLb RBL0_11 x264/WBL RBL1_15 RBL0_15 x262/WBLb x265/WBL x266/WWL RBL1_10
+ x264/WBLb RBL0_10 x267/WBL RBL1_13 RBL0_13 x268/WBL x266/VDD x265/WBLb x260/WBL
+ RBL1_9 x267/WBLb x261/WBL RBL0_9 RBL1_12 x268/WBLb RBL0_12 x263/WBL RBL1_14 VSUBS
+ x10T_1x8_magic
X10T_1x8_magic_63 RBL1_8 RBL0_8 RBL1_9 RBL0_9 RBL1_10 RBL0_10 RBL1_11 RBL1_12 RBL0_12
+ RBL1_13 RBL0_13 RBL1_14 RBL0_14 RBL1_15 RBL0_15 x25/WWL RWL_0 WBLb_8 WBL_8 WBLb_9
+ WBL_9 WBLb_10 WBL_10 WBLb_11 WBL_11 WBLb_12 WBL_12 WBLb_13 WBL_13 WBLb_14 WBL_14
+ WBLb_15 WBL_15 x25/VDD VSUBS x269/RBL0 x270/WBLb x270/RBL1 x271/WBLb x272/WBL x270/RBL0
+ x271/RBL1 x273/WBLb x271/RBL0 x274/WBL x273/RBL1 x273/RBL0 x272/WBLb x275/WBL x276/WWL
+ x272/RBL1 x274/WBLb x272/RBL0 x277/WBL x274/RBL1 x274/RBL0 x269/WBL x276/VDD x275/WBLb
+ x270/WBL x275/RBL1 x277/WBLb x271/WBL x275/RBL0 x277/RBL1 x269/WBLb x277/RBL0 x273/WBL
+ x269/RBL1 VSUBS x10T_1x8_magic
X10T_1x8_magic_121 RBL1_24 RBL0_24 RBL1_25 RBL0_25 RBL1_26 RBL0_26 RBL1_27 RBL1_28
+ RBL0_28 RBL1_29 RBL0_29 RBL1_30 RBL0_30 RBL1_31 RBL0_31 x221/WWL x221/RWL WBLb_24
+ WBL_24 WBLb_25 WBL_25 WBLb_26 WBL_26 WBLb_27 WBL_27 WBLb_28 WBL_28 WBLb_29 WBL_29
+ WBLb_30 WBL_30 WBLb_31 WBL_31 x221/VDD VSUBS x278/RBL0 x279/WBLb x279/RBL1 x280/WBLb
+ x281/WBL x279/RBL0 x280/RBL1 x282/WBLb x280/RBL0 x283/WBL x282/RBL1 x282/RBL0 x281/WBLb
+ x284/WBL x279/WWL x281/RBL1 x283/WBLb x281/RBL0 x285/WBL x283/RBL1 x283/RBL0 x278/WBL
+ x279/VDD x284/WBLb x279/WBL x284/RBL1 x285/WBLb x280/WBL x284/RBL0 x285/RBL1 x278/WBLb
+ x285/RBL0 x282/WBL x278/RBL1 VSUBS x10T_1x8_magic
X10T_1x8_magic_74 RBL1_16 RBL0_16 RBL1_17 RBL0_17 RBL1_18 RBL0_18 RBL1_19 RBL1_20
+ RBL0_20 RBL1_21 RBL0_21 RBL1_22 RBL0_22 RBL1_23 RBL0_23 x286/WWL RWL_26 WBLb_16
+ WBL_16 WBLb_17 WBL_17 WBLb_18 WBL_18 WBLb_19 WBL_19 WBLb_20 WBL_20 WBLb_21 WBL_21
+ WBLb_22 WBL_22 WBLb_23 WBL_23 x286/VDD VSUBS x287/RBL0 WBLb_16 x288/RBL1 x289/WBLb
+ x290/WBL x288/RBL0 x289/RBL1 x291/WBLb x289/RBL0 x292/WBL x291/RBL1 x291/RBL0 x290/WBLb
+ x293/WBL x294/WWL x290/RBL1 x292/WBLb x290/RBL0 x295/WBL RBL1_21 x292/RBL0 x287/WBL
+ x294/VDD x293/WBLb x288/WBL x293/RBL1 x295/WBLb x289/WBL x293/RBL0 x295/RBL1 x287/WBLb
+ x295/RBL0 x291/WBL x287/RBL1 VSUBS x10T_1x8_magic
X10T_1x8_magic_41 RBL1_8 RBL0_8 RBL1_9 RBL0_9 RBL1_10 RBL0_10 RBL1_11 RBL1_12 RBL0_12
+ RBL1_13 RBL0_13 RBL1_14 RBL0_14 RBL1_15 RBL0_15 x296/WWL RWL_22 WBLb_8 WBL_8 WBLb_9
+ WBL_9 WBLb_10 WBL_10 WBLb_11 WBL_11 WBLb_12 WBL_12 WBLb_13 WBL_13 WBLb_14 WBL_14
+ WBLb_15 WBL_15 x296/VDD VSUBS x297/RBL0 x298/WBLb x298/RBL1 x299/WBLb x300/WBL x298/RBL0
+ x299/RBL1 x301/WBLb x299/RBL0 x302/WBL x301/RBL1 x301/RBL0 x300/WBLb x303/WBL x140/WWL
+ x300/RBL1 x302/WBLb x300/RBL0 x304/WBL x302/RBL1 x302/RBL0 x297/WBL x140/VDD x303/WBLb
+ x298/WBL x303/RBL1 x304/WBLb x299/WBL x303/RBL0 x304/RBL1 x297/WBLb x304/RBL0 x301/WBL
+ x297/RBL1 VSUBS x10T_1x8_magic
X10T_1x8_magic_85 RBL1_24 RBL0_24 RBL1_25 RBL0_25 RBL1_26 RBL0_26 RBL1_27 RBL1_28
+ RBL0_28 RBL1_29 RBL0_29 RBL1_30 RBL0_30 RBL1_31 RBL0_31 x249/WWL RWL_21 WBLb_24
+ WBL_24 WBLb_25 WBL_25 WBLb_26 WBL_26 WBLb_27 WBL_27 WBLb_28 WBL_28 WBLb_29 WBL_29
+ WBLb_30 WBL_30 WBLb_31 WBL_31 x249/VDD VSUBS x305/RBL0 x306/WBLb x306/RBL1 x307/WBLb
+ x308/WBL x306/RBL0 x307/RBL1 x309/WBLb x307/RBL0 x310/WBL x309/RBL1 x309/RBL0 x308/WBLb
+ x311/WBL x306/WWL x308/RBL1 x310/WBLb x308/RBL0 x312/WBL x310/RBL1 x310/RBL0 x305/WBL
+ x306/VDD x311/WBLb x306/WBL x311/RBL1 x312/WBLb x307/WBL x311/RBL0 x312/RBL1 x305/WBLb
+ x312/RBL0 x309/WBL x305/RBL1 VSUBS x10T_1x8_magic
X10T_1x8_magic_30 RBL1_0 RBL0_0 RBL1_1 RBL0_1 RBL1_2 RBL0_2 RBL1_3 RBL1_4 RBL0_4 RBL1_5
+ RBL0_5 RBL1_6 RBL0_6 RBL1_7 RBL0_7 WWL_18 RWL_18 WBLb_0 WBL_0 WBLb_1 WBL_1 WBLb_2
+ WBL_2 WBLb_3 WBL_3 WBLb_4 WBL_4 WBLb_5 WBL_5 WBLb_6 WBL_6 WBLb_7 WBL_7 VDD GND x313/RBL0
+ x314/WBLb x314/RBL1 x315/WBLb x316/WBL x314/RBL0 x315/RBL1 x317/WBLb x315/RBL0 x318/WBL
+ x317/RBL1 x317/RBL0 x316/WBLb x319/WBL x320/WWL x316/RBL1 x318/WBLb x316/RBL0 x321/WBL
+ x318/RBL1 x318/RBL0 x313/WBL x320/VDD x319/WBLb x314/WBL x319/RBL1 x321/WBLb x315/WBL
+ x319/RBL0 x321/RBL1 x313/WBLb x321/RBL0 x317/WBL x313/RBL1 VSUBS x10T_1x8_magic
X10T_1x8_magic_96 RBL1_16 RBL0_16 RBL1_17 RBL0_17 RBL1_18 RBL0_18 RBL1_19 RBL1_20
+ RBL0_20 RBL1_21 RBL0_21 RBL1_22 RBL0_22 RBL1_23 RBL0_23 x322/WWL RWL_15 WBLb_16
+ WBL_16 WBLb_17 WBL_17 WBLb_18 WBL_18 WBLb_19 WBL_19 WBLb_20 WBL_20 WBLb_21 WBL_21
+ WBLb_22 WBL_22 WBLb_23 WBL_23 x322/VDD VSUBS x323/RBL0 WBLb_16 x324/RBL1 x325/WBLb
+ x326/WBL x324/RBL0 x325/RBL1 x327/WBLb x325/RBL0 x328/WBL x327/RBL1 x327/RBL0 x326/WBLb
+ x329/WBL x330/WWL x326/RBL1 x328/WBLb x326/RBL0 x331/WBL RBL1_21 x328/RBL0 x323/WBL
+ x330/VDD x329/WBLb x324/WBL x329/RBL1 x331/WBLb x325/WBL x329/RBL0 x331/RBL1 x323/WBLb
+ x331/RBL0 x327/WBL x323/RBL1 VSUBS x10T_1x8_magic
X10T_1x8_magic_52 RBL1_8 RBL0_8 RBL1_9 RBL0_9 RBL1_10 RBL0_10 RBL1_11 RBL1_12 RBL0_12
+ RBL1_13 RBL0_13 RBL1_14 RBL0_14 RBL1_15 RBL0_15 x332/WWL RWL_11 WBLb_8 WBL_8 WBLb_9
+ WBL_9 WBLb_10 WBL_10 WBLb_11 WBL_11 WBLb_12 WBL_12 WBLb_13 WBL_13 WBLb_14 WBL_14
+ WBLb_15 WBL_15 x332/VDD VSUBS x333/RBL0 x334/WBLb x334/RBL1 x335/WBLb x336/WBL x334/RBL0
+ x335/RBL1 x337/WBLb x335/RBL0 x338/WBL x337/RBL1 x337/RBL0 x336/WBLb x339/WBL x340/WWL
+ x336/RBL1 x338/WBLb x336/RBL0 x341/WBL x338/RBL1 x338/RBL0 x333/WBL x340/VDD x339/WBLb
+ x334/WBL x339/RBL1 x341/WBLb x335/WBL x339/RBL0 x341/RBL1 x333/WBLb x341/RBL0 x337/WBL
+ x333/RBL1 VSUBS x10T_1x8_magic
X10T_1x8_magic_110 RBL1_16 RBL0_16 RBL1_17 RBL0_17 RBL1_18 RBL0_18 RBL1_19 RBL1_20
+ RBL0_20 RBL1_21 RBL0_21 RBL1_22 RBL0_22 RBL1_23 RBL0_23 x342/WWL RWL_8 WBLb_16 WBL_16
+ WBLb_17 WBL_17 WBLb_18 WBL_18 WBLb_19 WBL_19 WBLb_20 WBL_20 WBLb_21 WBL_21 WBLb_22
+ WBL_22 WBLb_23 WBL_23 x342/VDD VSUBS x343/RBL0 WBLb_16 x344/RBL1 x345/WBLb x346/WBL
+ x344/RBL0 x345/RBL1 x347/WBLb x345/RBL0 x348/WBL x347/RBL1 x347/RBL0 x346/WBLb x349/WBL
+ x350/WWL x346/RBL1 x348/WBLb x346/RBL0 x351/WBL RBL1_21 x348/RBL0 x343/WBL x350/VDD
+ x349/WBLb x344/WBL x349/RBL1 x351/WBLb x345/WBL x349/RBL0 x351/RBL1 x343/WBLb x351/RBL0
+ x347/WBL x343/RBL1 VSUBS x10T_1x8_magic
X10T_1x8_magic_122 RBL1_16 RBL0_16 RBL1_17 RBL0_17 RBL1_18 RBL0_18 RBL1_19 RBL1_20
+ RBL0_20 RBL1_21 RBL0_21 RBL1_22 RBL0_22 RBL1_23 RBL0_23 x164/WWL RWL_2 WBLb_16 WBL_16
+ WBLb_17 WBL_17 WBLb_18 WBL_18 WBLb_19 WBL_19 WBLb_20 WBL_20 WBLb_21 WBL_21 WBLb_22
+ WBL_22 WBLb_23 WBL_23 x164/VDD VSUBS RBL0_22 WBLb_16 RBL1_16 x352/WBLb x353/WBL
+ RBL0_16 RBL1_19 x354/WBLb RBL0_19 x355/WBL RBL1_23 RBL0_23 x353/WBLb x356/WBL x357/WWL
+ RBL1_18 x355/WBLb RBL0_18 x358/WBL RBL1_21 RBL0_21 x359/WBL x357/VDD x356/WBLb x360/WBL
+ RBL1_17 x358/WBLb x352/WBL RBL0_17 RBL1_20 x359/WBLb RBL0_20 x354/WBL RBL1_22 VSUBS
+ x10T_1x8_magic
X10T_1x8_magic_64 RBL1_16 RBL0_16 RBL1_17 RBL0_17 RBL1_18 RBL0_18 RBL1_19 RBL1_20
+ RBL0_20 RBL1_21 RBL0_21 RBL1_22 RBL0_22 RBL1_23 RBL0_23 x361/WWL RWL_31 WBLb_16
+ WBL_16 WBLb_17 WBL_17 WBLb_18 WBL_18 WBLb_19 WBL_19 WBLb_20 WBL_20 WBLb_21 WBL_21
+ WBLb_22 WBL_22 WBLb_23 WBL_23 x361/VDD VSUBS x362/RBL0 WBLb_16 x363/RBL1 x364/WBLb
+ x365/WBL x363/RBL0 x364/RBL1 x366/WBLb x364/RBL0 x367/WBL x366/RBL1 x366/RBL0 x365/WBLb
+ x368/WBL x369/WWL x365/RBL1 x367/WBLb x365/RBL0 x370/WBL RBL1_21 x367/RBL0 x362/WBL
+ x369/VDD x368/WBLb x363/WBL x368/RBL1 x370/WBLb x364/WBL x368/RBL0 x370/RBL1 x362/WBLb
+ x370/RBL0 x366/WBL x362/RBL1 VSUBS x10T_1x8_magic
X10T_1x8_magic_20 RBL1_0 RBL0_0 RBL1_1 RBL0_1 RBL1_2 RBL0_2 RBL1_3 RBL1_4 RBL0_4 RBL1_5
+ RBL0_5 RBL1_6 RBL0_6 RBL1_7 RBL0_7 WWL_28 RWL_28 WBLb_0 WBL_0 WBLb_1 WBL_1 WBLb_2
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
