OpenPOWERFoundation/toy-sram/custom/magic/x10T_32x32_magic.spice

* HSPICE file created from 10T_32x32_magic.ext - technology: sky130A

.option scale=0.005u

.subckt x10T_32x32_magic RBL1_0 RBL0_0 RBL1_1 RBL0_1 RBL1_2 RBL0_2 RBL1_3 RBL0_3 RBL1_4
+ RBL0_4 RBL1_5 RBL0_5 RBL1_6 RBL0_6 RBL1_7 RBL0_7 RBL1_8 RBL0_8 RBL1_9 RBL0_9 RBL1_10
+ RBL0_10 RBL1_11 RBL0_11 RBL1_12 RBL0_12 RBL1_13 RBL0_13 RBL1_14 RBL0_14 RBL1_15
+ RBL0_15 WWL_0 RWL_0 WWL_1 RWL_1 WWL_2 RWL_2 WWL_3 RWL_3 WWL_4 RWL_4 WWL_5 RWL_5
+ WWL_6 RWL_6 WWL_7 RWL_7 WWL_8 RWL_8 WWL_9 RWL_9 WWL_10 RWL_10 WWL_11 RWL_11 WWL_12
+ RWL_12 WWL_13 RWL_13 WWL_14 RWL_14 WWL_15 RWL_15 WWL_16 RWL_16 WWL_17 RWL_17 WWL_18
+ RWL_18 WWL_19 RWL_19 WWL_20 RWL_20 WWL_21 RWL_21 WWL_22 RWL_22 WWL_23 RWL_23 WWL_24
+ RWL_24 WWL_25 RWL_25 WWL_26 RWL_26 WWL_27 RWL_27 WWL_28 RWL_28 WWL_29 RWL_29 WWL_30
+ RWL_30 WWL_31 RWL_31 RBL1_16 RBL0_16 RBL1_17 RBL0_17 RBL1_18 RBL0_18 RBL1_19 RBL0_19
+ RBL1_20 RBL0_20 RBL1_21 RBL0_21 RBL1_22 RBL0_22 RBL1_23 RBL0_23 RBL1_24 RBL0_24
+ RBL1_25 RBL0_25 RBL1_26 RBL0_26 RBL1_27 RBL0_27 RBL1_28 RBL0_28 RBL1_29 RBL0_29
+ RBL1_30 RBL0_30 RBL1_31 RBL0_31 WBL_0 WBLb_0 WBL_1 WBLb_1 WBL_2 WBLb_2 WBL_3 WBLb_19
+ WBL_4 WBLb_4 WBL_5 WBLb_5 WBL_22 WBLb_6 WBL_23 WBLb_7 WBL_24 WBLb_8 WBL_25 WBLb_9
+ WBL_26 WBLb_10 WBL_11 WBLb_11 WBL_12 WBLb_12 WBL_13 WBLb_13 WBL_14 WBLb_30 WBL_15
+ WBLb_31 VDD GND
C0 RWL_11 x0/VDD 2.32fF
C1 RBL0_12 RBL1_13 2.23fF
C2 x1/VDD RWL_8 2.32fF
C3 RWL_12 x2/VDD 2.32fF
C4 x3/VDD RWL_21 2.32fF
C5 x4/VDD RWL_22 2.32fF
C6 x5/VDD RWL_14 2.32fF
C7 x6/VDD RWL_26 2.32fF
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
+ WBL_22 WBLb_23 WBL_23 x72/VDD VSUBS x10T_1x8_magic
X10T_1x8_magic_8 RBL1_0 RBL0_0 RBL1_1 RBL0_1 RBL1_2 RBL0_2 RBL1_3 RBL1_4 RBL0_4 RBL1_5
+ RBL0_5 RBL1_6 RBL0_6 RBL1_7 RBL0_7 WWL_14 RWL_14 WBLb_0 WBL_0 WBLb_1 WBL_1 WBLb_2
+ WBL_2 WBLb_3 WBL_3 WBLb_4 WBL_4 WBLb_5 WBL_5 WBLb_6 WBL_6 WBLb_7 WBL_7 VDD GND x10T_1x8_magic
X10T_1x8_magic_80 RBL1_16 RBL0_16 RBL1_17 RBL0_17 RBL1_18 RBL0_18 RBL1_19 RBL1_20
+ RBL0_20 RBL1_21 RBL0_21 RBL1_22 RBL0_22 RBL1_23 RBL0_23 x120/WWL RWL_23 WBLb_16
+ WBL_16 WBLb_17 WBL_17 WBLb_18 WBL_18 WBLb_19 WBL_19 WBLb_20 WBL_20 WBLb_21 WBL_21
+ WBLb_22 WBL_22 WBLb_23 WBL_23 VDD VSUBS x10T_1x8_magic
X10T_1x8_magic_91 RBL1_16 RBL0_16 RBL1_17 RBL0_17 RBL1_18 RBL0_18 RBL1_19 RBL1_20
+ RBL0_20 RBL1_21 RBL0_21 RBL1_22 RBL0_22 RBL1_23 RBL0_23 x105/WWL RWL_18 WBLb_16
+ WBL_16 WBLb_17 WBL_17 WBLb_18 WBL_18 WBLb_19 WBL_19 WBLb_20 WBL_20 WBLb_21 WBL_21
+ WBLb_22 WBL_22 WBLb_23 WBL_23 x105/VDD VSUBS x10T_1x8_magic
X10T_1x8_magic_70 RBL1_16 RBL0_16 RBL1_17 RBL0_17 RBL1_18 RBL0_18 RBL1_19 RBL1_20
+ RBL0_20 RBL1_21 RBL0_21 RBL1_22 RBL0_22 RBL1_23 RBL0_23 x57/WWL RWL_28 WBLb_16 WBL_16
+ WBLb_17 WBL_17 WBLb_18 WBL_18 WBLb_19 WBL_19 WBLb_20 WBL_20 WBLb_21 WBL_21 WBLb_22
+ WBL_22 WBLb_23 WBL_23 x57/VDD VSUBS x10T_1x8_magic
X10T_1x8_magic_81 RBL1_24 RBL0_24 RBL1_25 RBL0_25 RBL1_26 RBL0_26 RBL1_27 RBL1_28
+ RBL0_28 RBL1_29 RBL0_29 RBL1_30 RBL0_30 RBL1_31 RBL0_31 x121/WWL RWL_23 WBLb_24
+ WBL_24 WBLb_25 WBL_25 WBLb_26 WBL_26 WBLb_27 WBL_27 WBLb_28 WBL_28 WBLb_29 WBL_29
+ WBLb_30 WBL_30 WBLb_31 WBL_31 VDD VSUBS x10T_1x8_magic
X10T_1x8_magic_92 RBL1_24 RBL0_24 RBL1_25 RBL0_25 RBL1_26 RBL0_26 RBL1_27 RBL1_28
+ RBL0_28 RBL1_29 RBL0_29 RBL1_30 RBL0_30 RBL1_31 RBL0_31 x104/WWL RWL_17 WBLb_24
+ WBL_24 WBLb_25 WBL_25 WBLb_26 WBL_26 WBLb_27 WBL_27 WBLb_28 WBL_28 WBLb_29 WBL_29
+ WBLb_30 WBL_30 WBLb_31 WBL_31 x104/VDD VSUBS x10T_1x8_magic
X10T_1x8_magic_9 RBL1_0 RBL0_0 RBL1_1 RBL0_1 RBL1_2 RBL0_2 RBL1_3 RBL1_4 RBL0_4 RBL1_5
+ RBL0_5 RBL1_6 RBL0_6 RBL1_7 RBL0_7 WWL_15 RWL_15 WBLb_0 WBL_0 WBLb_1 WBL_1 WBLb_2
+ WBL_2 WBLb_3 WBL_3 WBLb_4 WBL_4 WBLb_5 WBL_5 WBLb_6 WBL_6 WBLb_7 WBL_7 VDD GND x10T_1x8_magic
X10T_1x8_magic_60 RBL1_8 RBL0_8 RBL1_9 RBL0_9 RBL1_10 RBL0_10 RBL1_11 RBL1_12 RBL0_12
+ RBL1_13 RBL0_13 RBL1_14 RBL0_14 RBL1_15 RBL0_15 x19/WWL x19/RWL WBLb_8 WBL_8 WBLb_9
+ WBL_9 WBLb_10 WBL_10 WBLb_11 WBL_11 WBLb_12 WBL_12 WBLb_13 WBL_13 WBLb_14 WBL_14
+ WBLb_15 WBL_15 x19/VDD VSUBS x10T_1x8_magic
X10T_1x8_magic_71 RBL1_24 RBL0_24 RBL1_25 RBL0_25 RBL1_26 RBL0_26 RBL1_27 RBL1_28
+ RBL0_28 RBL1_29 RBL0_29 RBL1_30 RBL0_30 RBL1_31 RBL0_31 x86/WWL RWL_28 WBLb_24 WBL_24
+ WBLb_25 WBL_25 WBLb_26 WBL_26 WBLb_27 WBL_27 WBLb_28 WBL_28 WBLb_29 WBL_29 WBLb_30
+ WBL_30 WBLb_31 WBL_31 x86/VDD VSUBS x10T_1x8_magic
X10T_1x8_magic_82 RBL1_16 RBL0_16 RBL1_17 RBL0_17 RBL1_18 RBL0_18 RBL1_19 RBL1_20
+ RBL0_20 RBL1_21 RBL0_21 RBL1_22 RBL0_22 RBL1_23 RBL0_23 x84/WWL RWL_22 WBLb_16 WBL_16
+ WBLb_17 WBL_17 WBLb_18 WBL_18 WBLb_19 WBL_19 WBLb_20 WBL_20 WBLb_21 WBL_21 WBLb_22
+ WBL_22 WBLb_23 WBL_23 x84/VDD VSUBS x10T_1x8_magic
X10T_1x8_magic_93 RBL1_24 RBL0_24 RBL1_25 RBL0_25 RBL1_26 RBL0_26 RBL1_27 RBL1_28
+ RBL0_28 RBL1_29 RBL0_29 RBL1_30 RBL0_30 RBL1_31 RBL0_31 x110/WWL RWL_18 WBLb_24
+ WBL_24 WBLb_25 WBL_25 WBLb_26 WBL_26 WBLb_27 WBL_27 WBLb_28 WBL_28 WBLb_29 WBL_29
+ WBLb_30 WBL_30 WBLb_31 WBL_31 x110/VDD VSUBS x10T_1x8_magic
X10T_1x8_magic_61 RBL1_8 RBL0_8 RBL1_9 RBL0_9 RBL1_10 RBL0_10 RBL1_11 RBL1_12 RBL0_12
+ RBL1_13 RBL0_13 RBL1_14 RBL0_14 RBL1_15 RBL0_15 x102/WWL RWL_2 WBLb_8 WBL_8 WBLb_9
+ WBL_9 WBLb_10 WBL_10 WBLb_11 WBL_11 WBLb_12 WBL_12 WBLb_13 WBL_13 WBLb_14 WBL_14
+ WBLb_15 WBL_15 x102/VDD VSUBS x10T_1x8_magic
X10T_1x8_magic_72 RBL1_16 RBL0_16 RBL1_17 RBL0_17 RBL1_18 RBL0_18 RBL1_19 RBL1_20
+ RBL0_20 RBL1_21 RBL0_21 RBL1_22 RBL0_22 RBL1_23 RBL0_23 x39/WWL RWL_27 WBLb_16 WBL_16
+ WBLb_17 WBL_17 WBLb_18 WBL_18 WBLb_19 WBL_19 WBLb_20 WBL_20 WBLb_21 WBL_21 WBLb_22
+ WBL_22 WBLb_23 WBL_23 x39/VDD VSUBS x10T_1x8_magic
X10T_1x8_magic_83 RBL1_24 RBL0_24 RBL1_25 RBL0_25 RBL1_26 RBL0_26 RBL1_27 RBL1_28
+ RBL0_28 RBL1_29 RBL0_29 RBL1_30 RBL0_30 RBL1_31 RBL0_31 x28/WWL RWL_22 WBLb_24 WBL_24
+ WBLb_25 WBL_25 WBLb_26 WBL_26 WBLb_27 WBL_27 WBLb_28 WBL_28 WBLb_29 WBL_29 WBLb_30
+ WBL_30 WBLb_31 WBL_31 x28/VDD VSUBS x10T_1x8_magic
X10T_1x8_magic_94 RBL1_16 RBL0_16 RBL1_17 RBL0_17 RBL1_18 RBL0_18 RBL1_19 RBL1_20
+ RBL0_20 RBL1_21 RBL0_21 RBL1_22 RBL0_22 RBL1_23 RBL0_23 x78/WWL RWL_16 WBLb_16 WBL_16
+ WBLb_17 WBL_17 WBLb_18 WBL_18 WBLb_19 WBL_19 WBLb_20 WBL_20 WBLb_21 WBL_21 WBLb_22
+ WBL_22 WBLb_23 WBL_23 x78/VDD VSUBS x10T_1x8_magic
X10T_1x8_magic_50 RBL1_8 RBL0_8 RBL1_9 RBL0_9 RBL1_10 RBL0_10 RBL1_11 RBL1_12 RBL0_12
+ RBL1_13 RBL0_13 RBL1_14 RBL0_14 RBL1_15 RBL0_15 x106/WWL RWL_13 WBLb_8 WBL_8 WBLb_9
+ WBL_9 WBLb_10 WBL_10 WBLb_11 WBL_11 WBLb_12 WBL_12 WBLb_13 WBL_13 WBLb_14 WBL_14
+ WBLb_15 WBL_15 x106/VDD VSUBS x10T_1x8_magic
X10T_1x8_magic_62 RBL1_8 RBL0_8 RBL1_9 RBL0_9 RBL1_10 RBL0_10 RBL1_11 RBL1_12 RBL0_12
+ RBL1_13 RBL0_13 RBL1_14 RBL0_14 RBL1_15 RBL0_15 x76/WWL RWL_1 WBLb_8 WBL_8 WBLb_9
+ WBL_9 WBLb_10 WBL_10 WBLb_11 WBL_11 WBLb_12 WBL_12 WBLb_13 WBL_13 WBLb_14 WBL_14
+ WBLb_15 WBL_15 x76/VDD VSUBS x10T_1x8_magic
X10T_1x8_magic_120 RBL1_16 RBL0_16 RBL1_17 RBL0_17 RBL1_18 RBL0_18 RBL1_19 RBL1_20
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
