OpenPOWERFoundation/toy-sram/rtl/src/array/ra_64x72_2r1w.v

// © IBM Corp. 2022
// Licensed under the Apache License, Version 2.0 (the "License"), as modified by the terms below; you may not use the files in this
// repository except in compliance with the License as modified.
// You may obtain a copy of the License at http://www.apache.org/licenses/LICENSE-2.0
//
// Modified Terms:
//
//   1)	For the purpose of the patent license granted to you in Section 3 of the License, the "Work" hereby includes implementations of
//   the work of authorship in physical form.
//
// Unless required by applicable law or agreed to in writing, the reference design distributed under the License is distributed on an
// "AS IS" BASIS, WITHOUT WARRANTIES OR CONDITIONS OF ANY KIND, either express or implied. See the License for the specific language
// governing permissions and limitations under the License.
//
// Brief explanation of modifications:
//
// Modification 1: This modification extends the patent license to an implementation of the Work in physical form – i.e.,
// it unambiguously permits a user to make and use the physical chip.


// Logical wrapper for 64x72 array (SDR)
// Configurable for read latching

`timescale 1 ns / 1 ns

module ra_64x72_2r1w #(

    parameter GENMODE,            	        // 0=NoDelay, 1=Delay
    parameter LATCHRD = 1                   // 1=latch read data, 0=unlatched

) (

    input         clk,
    input         reset,
    input         strobe,
    input         rd_enb_0,
    input  [0:5]  rd_adr_0,
    output [0:71] rd_dat_0,
    input         rd_enb_1,
    input  [0:5]  rd_adr_1,
    output [0:71] rd_dat_1,
    input         wr_enb_0,
    input  [0:5]  wr_adr_0,
    input  [0:71] wr_dat_0

);

reg          rd_enb_0_q;
reg [0:5]    rd_adr_0_q;
reg [0:71]   rd_dat_0_q;

reg          rd_enb_1_q;
reg [0:5]    rd_adr_1_q;
reg [0:71]   rd_dat_1_q;

reg          wr_enb_0_q;
reg [0:5]    wr_adr_0_q;
reg [0:71]   wr_dat_0_q;

wire         rd0_c_na0;
wire         rd0_c_a0;
wire         rd0_na1_na2;
wire         rd0_na1_a2;
wire         rd0_a1_na2;
wire         rd0_a1_a2;
wire         rd0_na3;
wire         rd0_a3;
wire         rd0_na4_na5;
wire         rd0_na4_a5;
wire         rd0_a4_na5;
wire         rd0_a4_a5;
wire [0:71]  ra_rd_dat_0;

wire         rd1_c_na0;
wire         rd1_c_a0;
wire         rd1_na1_na2;
wire         rd1_na1_a2;
wire         rd1_a1_na2;
wire         rd1_a1_a2;
wire         rd1_na3;
wire         rd1_a3;
wire         rd1_na4_na5;
wire         rd1_na4_a5;
wire         rd1_a4_na5;
wire         rd1_a4_a5;
wire [0:71]  ra_rd_dat_1;

wire         wr0_c_na0;
wire         wr0_c_a0;
wire         wr0_na1_na2;
wire         wr0_na1_a2;
wire         wr0_a1_na2;
wire         wr0_a1_a2;
wire         wr0_na3;
wire         wr0_a3;
wire         wr0_na4_na5;
wire         wr0_na4_a5;
wire         wr0_a4_na5;
wire         wr0_a4_a5;
wire         ra_wr_enb_0;
wire [0:5]   ra_wr_adr_0;
wire [0:71]  ra_wr_dat_0;
wire         strobe_int;

// latch inputs
// reset all; only enb required
always @ (posedge clk) begin
   if (reset == 1'b1) begin
      rd_enb_0_q <= 0;
      rd_adr_0_q <= 0;
      rd_enb_1_q <= 0;
      rd_adr_1_q <= 0;
      wr_enb_0_q <= 0;
      wr_adr_0_q <= 0;
      wr_dat_0_q <= 0;
   end else begin
      rd_enb_0_q <= rd_enb_0;
      rd_adr_0_q <= rd_adr_0;
      rd_enb_1_q <= rd_enb_1;
      rd_adr_1_q <= rd_adr_1;
      wr_enb_0_q <= wr_enb_0;
      wr_adr_0_q <= wr_adr_0;
      wr_dat_0_q <= wr_dat_0;
   end
end

// latch read data conditionally
generate

   if (LATCHRD) begin
     always @ (posedge clk) begin
     	rd_dat_0_q <= ra_rd_dat_0;
     	rd_dat_1_q <= ra_rd_dat_1;
     end
     assign rd_dat_0 = rd_dat_0_q;
     assign rd_dat_1 = rd_dat_1_q;
  end else begin
     assign rd_dat_0 = ra_rd_dat_0;
     assign rd_dat_1 = ra_rd_dat_1;
  end

endgenerate

// toysram_16x12 component needs rising edge to check wwl
assign strobe_int = strobe;

// generate the controls for the array

address_clock #(

      .GENMODE(GENMODE)

) add_clk (

      .strobe       (strobe_int),

      .rd_enb_0     (rd_enb_0_q),
      .rd_adr_0     (rd_adr_0_q),
      .rd_enb_1     (rd_enb_1_q),
      .rd_adr_1     (rd_adr_1_q),
      .wr_enb_0     (wr_enb_0_q),
      .wr_adr_0     (wr_adr_0_q),

      .rd0_c_na0   (rd0_c_na0),
      .rd0_c_a0    (rd0_c_a0),
      .rd0_na1_na2 (rd0_na1_na2),
      .rd0_na1_a2  (rd0_na1_a2),
      .rd0_a1_na2  (rd0_a1_na2),
      .rd0_a1_a2   (rd0_a1_a2),
      .rd0_na3     (rd0_na3),
      .rd0_a3      (rd0_a3),
      .rd0_na4_na5 (rd0_na4_na5),
      .rd0_na4_a5  (rd0_na4_a5),
      .rd0_a4_na5  (rd0_a4_na5),
      .rd0_a4_a5   (rd0_a4_a5),

      .rd1_c_na0   (rd1_c_na0),
      .rd1_c_a0    (rd1_c_a0),
      .rd1_na1_na2 (rd1_na1_na2),
      .rd1_na1_a2  (rd1_na1_a2),
      .rd1_a1_na2  (rd1_a1_na2),
      .rd1_a1_a2   (rd1_a1_a2),
      .rd1_na3     (rd1_na3),
      .rd1_a3      (rd1_a3),
      .rd1_na4_na5 (rd1_na4_na5),
      .rd1_na4_a5  (rd1_na4_a5),
      .rd1_a4_na5  (rd1_a4_na5),
      .rd1_a4_a5   (rd1_a4_a5),

      .wr0_c_na0   (wr0_c_na0),
      .wr0_c_a0    (wr0_c_a0),
      .wr0_na1_na2 (wr0_na1_na2),
      .wr0_na1_a2  (wr0_na1_a2),
      .wr0_a1_na2  (wr0_a1_na2),
      .wr0_a1_a2   (wr0_a1_a2),
      .wr0_na3     (wr0_na3),
      .wr0_a3      (wr0_a3),
      .wr0_na4_na5 (wr0_na4_na5),
      .wr0_na4_a5  (wr0_na4_a5),
      .wr0_a4_na5  (wr0_a4_na5),
      .wr0_a4_a5   (wr0_a4_a5)

);

regfile_64x24_2r1w ra0(

      .rd0_c_na0   (rd0_c_na0),
      .rd0_c_a0    (rd0_c_a0),
      .rd0_na1_na2 (rd0_na1_na2),
      .rd0_na1_a2  (rd0_na1_a2),
      .rd0_a1_na2  (rd0_a1_na2),
      .rd0_a1_a2   (rd0_a1_a2),
      .rd0_na3     (rd0_na3),
      .rd0_a3      (rd0_a3),
      .rd0_na4_na5 (rd0_na4_na5),
      .rd0_na4_a5  (rd0_na4_a5),
      .rd0_a4_na5  (rd0_a4_na5),
      .rd0_a4_a5   (rd0_a4_a5),
      .rd0_dat     (ra_rd_dat_0[0:23]),

      .rd1_c_na0   (rd1_c_na0),
      .rd1_c_a0    (rd1_c_a0),
      .rd1_na1_na2 (rd1_na1_na2),
      .rd1_na1_a2  (rd1_na1_a2),
      .rd1_a1_na2  (rd1_a1_na2),
      .rd1_a1_a2   (rd1_a1_a2),
      .rd1_na3     (rd1_na3),
      .rd1_a3      (rd1_a3),
      .rd1_na4_na5 (rd1_na4_na5),
      .rd1_na4_a5  (rd1_na4_a5),
      .rd1_a4_na5  (rd1_a4_na5),
      .rd1_a4_a5   (rd1_a4_a5),
      .rd1_dat     (ra_rd_dat_1[0:23]),

      .wr0_c_na0   (wr0_c_na0),
      .wr0_c_a0    (wr0_c_a0),
      .wr0_na1_na2 (wr0_na1_na2),
      .wr0_na1_a2  (wr0_na1_a2),
      .wr0_a1_na2  (wr0_a1_na2),
      .wr0_a1_a2   (wr0_a1_a2),
      .wr0_na3     (wr0_na3),
      .wr0_a3      (wr0_a3),
      .wr0_na4_na5 (wr0_na4_na5),
      .wr0_na4_a5  (wr0_na4_a5),
      .wr0_a4_na5  (wr0_a4_na5),
      .wr0_a4_a5   (wr0_a4_a5),
      .wr0_dat     (wr_dat_0_q[0:23])

);

regfile_64x24_2r1w ra1(

      .rd0_c_na0   (rd0_c_na0),
      .rd0_c_a0    (rd0_c_a0),
      .rd0_na1_na2 (rd0_na1_na2),
      .rd0_na1_a2  (rd0_na1_a2),
      .rd0_a1_na2  (rd0_a1_na2),
      .rd0_a1_a2   (rd0_a1_a2),
      .rd0_na3     (rd0_na3),
      .rd0_a3      (rd0_a3),
      .rd0_na4_na5 (rd0_na4_na5),
      .rd0_na4_a5  (rd0_na4_a5),
      .rd0_a4_na5  (rd0_a4_na5),
      .rd0_a4_a5   (rd0_a4_a5),
      .rd0_dat     (ra_rd_dat_0[24:47]),

      .rd1_c_na0   (rd1_c_na0),
      .rd1_c_a0    (rd1_c_a0),
      .rd1_na1_na2 (rd1_na1_na2),
      .rd1_na1_a2  (rd1_na1_a2),
      .rd1_a1_na2  (rd1_a1_na2),
      .rd1_a1_a2   (rd1_a1_a2),
      .rd1_na3     (rd1_na3),
      .rd1_a3      (rd1_a3),
      .rd1_na4_na5 (rd1_na4_na5),
      .rd1_na4_a5  (rd1_na4_a5),
      .rd1_a4_na5  (rd1_a4_na5),
      .rd1_a4_a5   (rd1_a4_a5),
      .rd1_dat     (ra_rd_dat_1[24:47]),

      .wr0_c_na0   (wr0_c_na0),
      .wr0_c_a0    (wr0_c_a0),
      .wr0_na1_na2 (wr0_na1_na2),
      .wr0_na1_a2  (wr0_na1_a2),
      .wr0_a1_na2  (wr0_a1_na2),
      .wr0_a1_a2   (wr0_a1_a2),
      .wr0_na3     (wr0_na3),
      .wr0_a3      (wr0_a3),
      .wr0_na4_na5 (wr0_na4_na5),
      .wr0_na4_a5  (wr0_na4_a5),
      .wr0_a4_na5  (wr0_a4_na5),
      .wr0_a4_a5   (wr0_a4_a5),
      .wr0_dat     (wr_dat_0_q[24:47])

);

regfile_64x24_2r1w ra2 (

      .rd0_c_na0   (rd0_c_na0),
      .rd0_c_a0    (rd0_c_a0),
      .rd0_na1_na2 (rd0_na1_na2),
      .rd0_na1_a2  (rd0_na1_a2),
      .rd0_a1_na2  (rd0_a1_na2),
      .rd0_a1_a2   (rd0_a1_a2),
      .rd0_na3     (rd0_na3),
      .rd0_a3      (rd0_a3),
      .rd0_na4_na5 (rd0_na4_na5),
      .rd0_na4_a5  (rd0_na4_a5),
      .rd0_a4_na5  (rd0_a4_na5),
      .rd0_a4_a5   (rd0_a4_a5),
      .rd0_dat     (ra_rd_dat_0[48:71]),

      .rd1_c_na0   (rd1_c_na0),
      .rd1_c_a0    (rd1_c_a0),
      .rd1_na1_na2 (rd1_na1_na2),
      .rd1_na1_a2  (rd1_na1_a2),
      .rd1_a1_na2  (rd1_a1_na2),
      .rd1_a1_a2   (rd1_a1_a2),
      .rd1_na3     (rd1_na3),
      .rd1_a3      (rd1_a3),
      .rd1_na4_na5 (rd1_na4_na5),
      .rd1_na4_a5  (rd1_na4_a5),
      .rd1_a4_na5  (rd1_a4_na5),
      .rd1_a4_a5   (rd1_a4_a5),
      .rd1_dat     (ra_rd_dat_1[48:71]),

      .wr0_c_na0   (wr0_c_na0),
      .wr0_c_a0    (wr0_c_a0),
      .wr0_na1_na2 (wr0_na1_na2),
      .wr0_na1_a2  (wr0_na1_a2),
      .wr0_a1_na2  (wr0_a1_na2),
      .wr0_a1_a2   (wr0_a1_a2),
      .wr0_na3     (wr0_na3),
      .wr0_a3      (wr0_a3),
      .wr0_na4_na5 (wr0_na4_na5),
      .wr0_na4_a5  (wr0_na4_a5),
      .wr0_a4_na5  (wr0_a4_na5),
      .wr0_a4_a5   (wr0_a4_a5),
      .wr0_dat     (wr_dat_0_q[48:71])

);

endmodule
