OpenPOWERFoundation/toy-sram/(commit log)

2022-08-29 add custom
    [10T_1x32_xschem.sch, 10T_1x8_xschem.sch, 10T_2x8_xschem.sch, 10T_32x32_xschem.sch, 10T_4x4.sch, 10T_4x4_xschem.sch, 10T_8x8_xschem.sch, 10T_toy_xschem.sch]
2022-11-15 custom junk and site verif from mpw7
    [local_eval.sch, lsdl_1.sch]
